kawasakizx10rr/HydroController/Code/ESP8266/ReadMe.MD

This code has not been fully tested, as such this code is not currently fit for release, please only use this code for testing.
