kawasakizx10rr/HydroController/PCB/Hydro Iss8 to Iss9 changes.docx

1. Added I2C header (PL12)

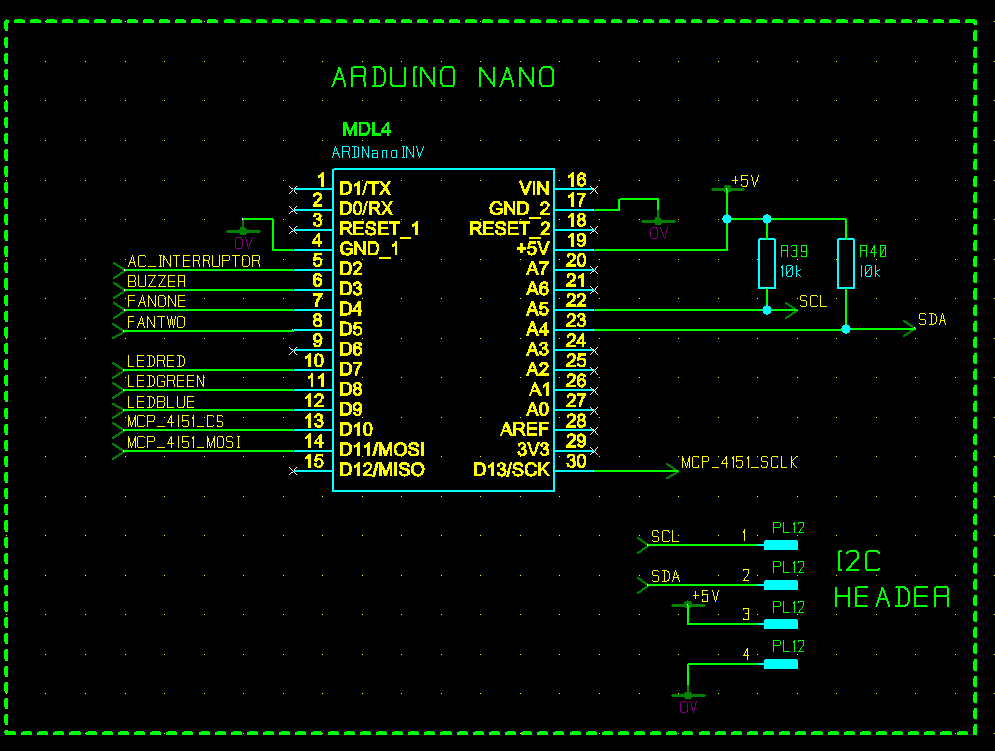
[picture p11: figure]
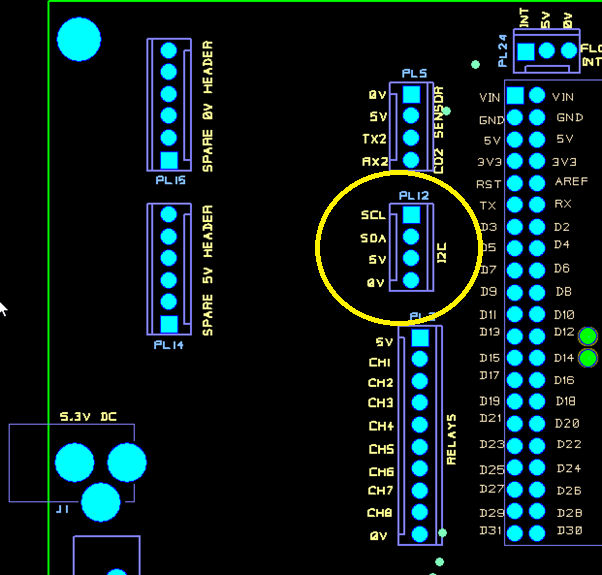
[picture p12: figure]

2. Add TFT jumper select 3V3 or 5V (PL28)

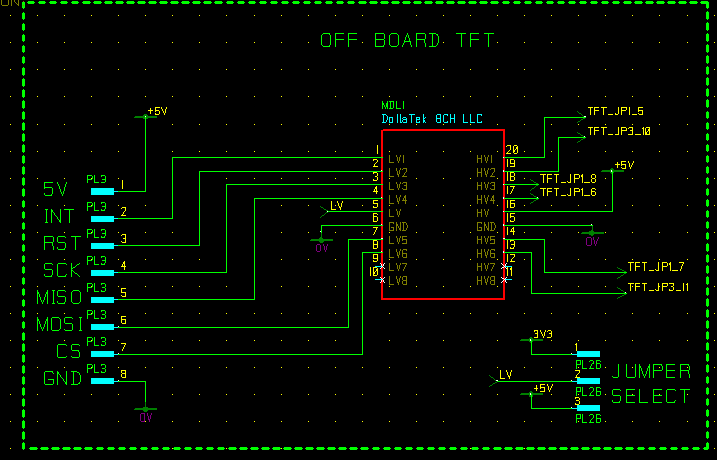
[picture p13: figure]
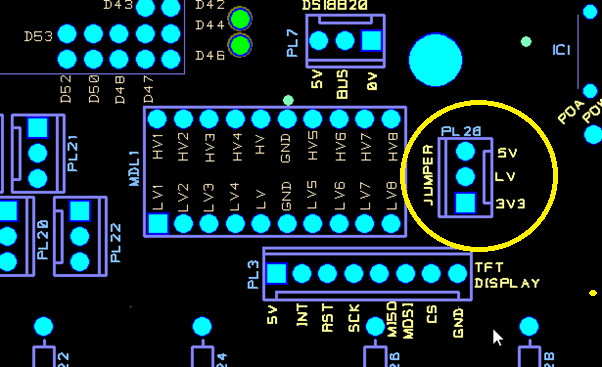
[picture p14: figure]

3. Add Analog potentiometer (R31) as an alternative to digital with DIP switches (S2).

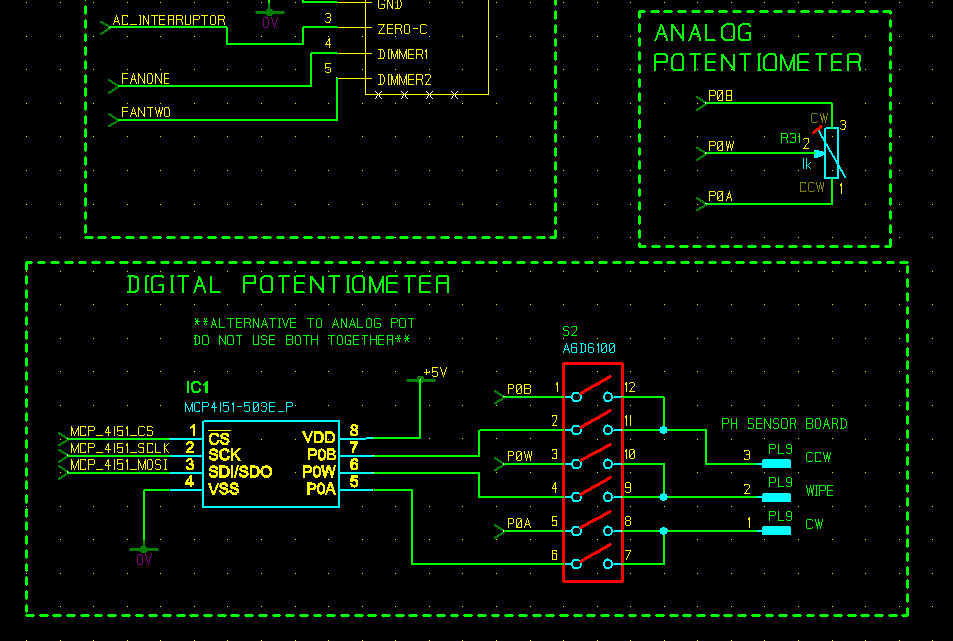
[picture p15: figure]
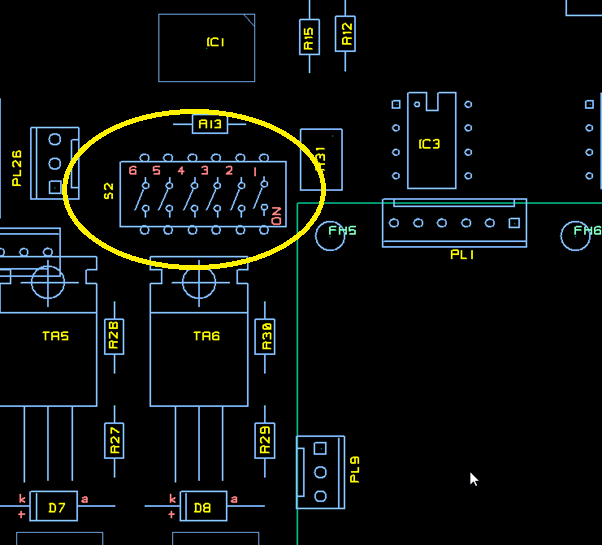
[picture p16: figure]

4. Add adjustable switching (Boost) regulator to power the pumps (MDL6).

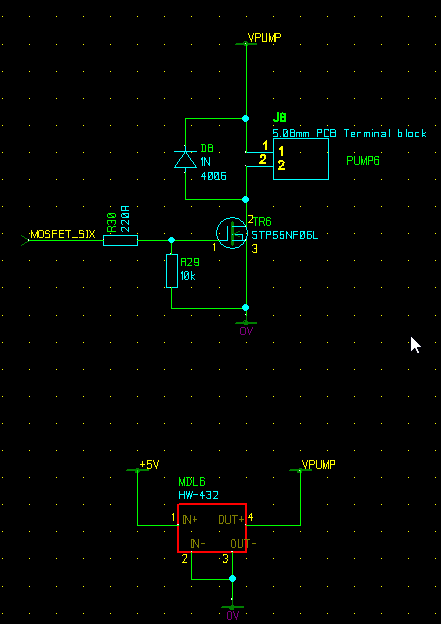
[picture p17: figure]
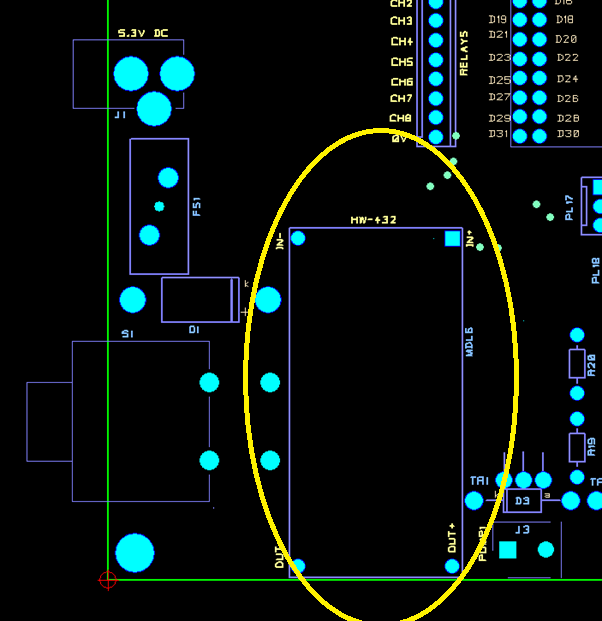
[picture p18: figure]

Overall board shown

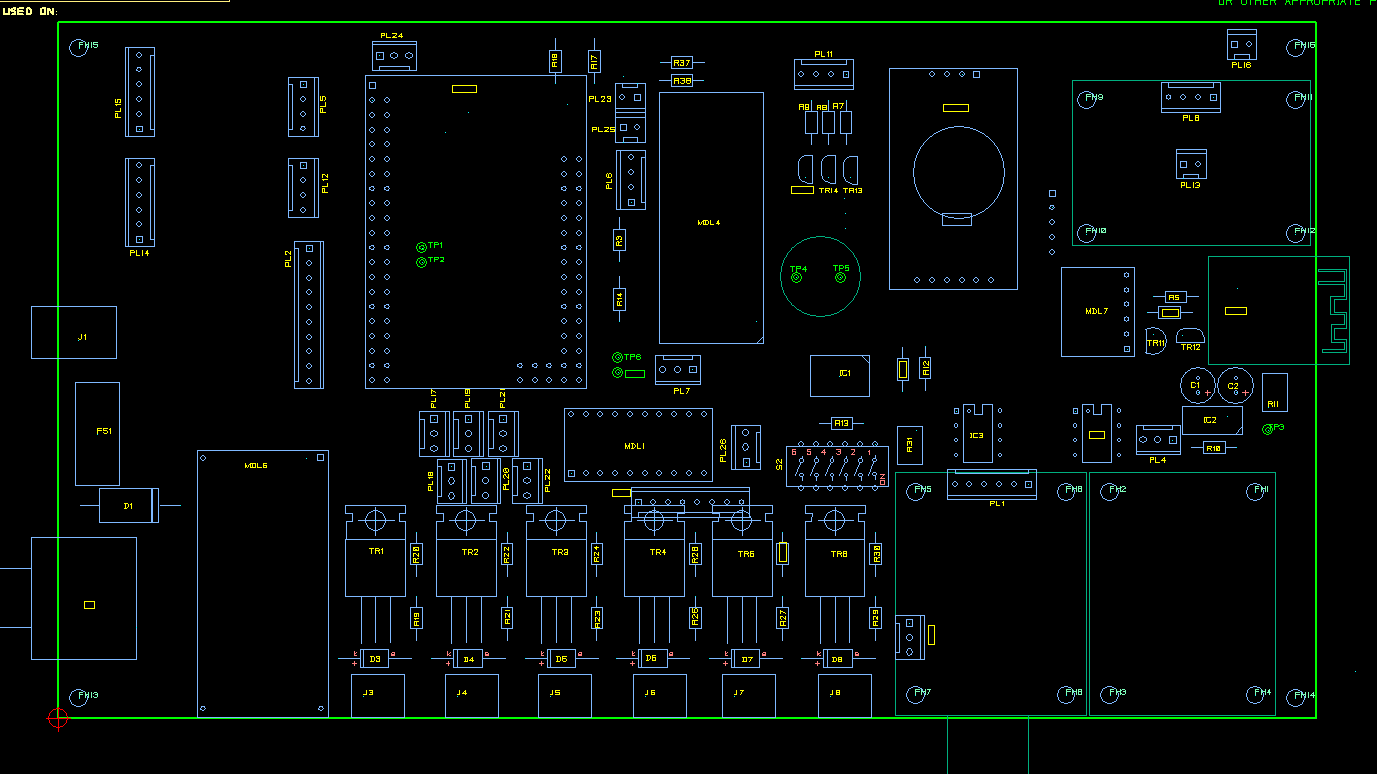
[picture p19: figure]

Top side

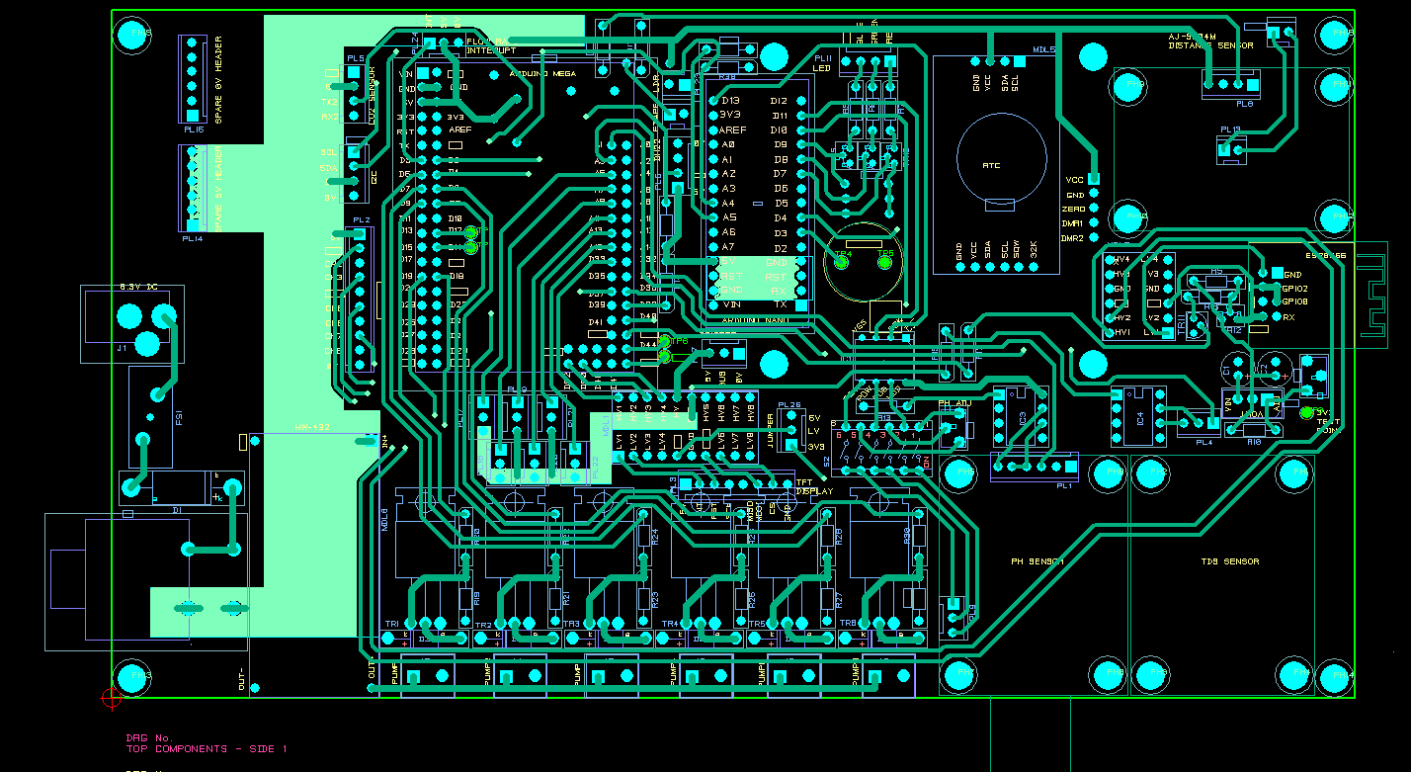
[picture p20: figure]

Bottom side (looking through board)

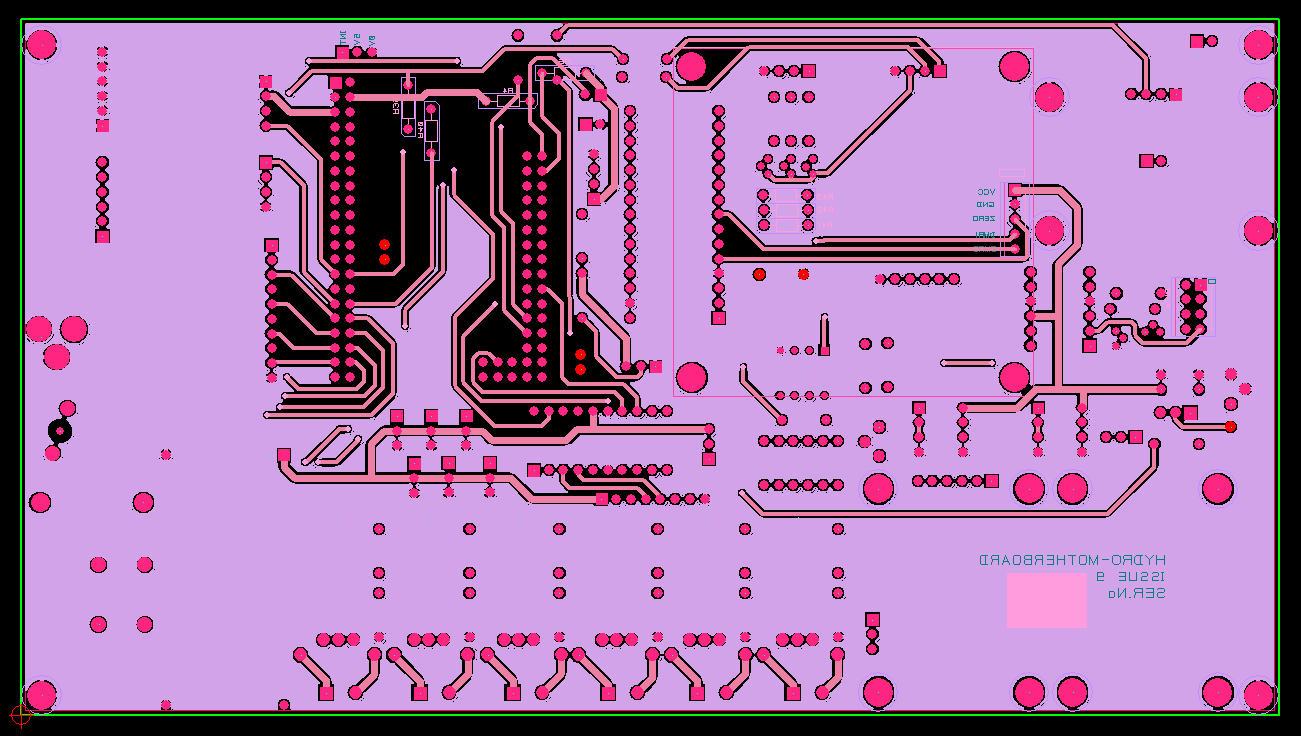
[picture p21: figure]
