kawasakizx10rr/HydroController/(threads)

Thread 3 (2023-12-04):

A few bugs

lvagabond, 2023-12-04:
Hi, your controller is great, but I ran into a few bugs while using it. In the controller log, wrong characters appear or they overlap and another error, when changing the number of dispensers to 4 and then back to 6, it is no longer possible to melt and there is even 16. What is the reason for this? Or is the fault only with my regulator?

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

lvagabond, 2023-12-05:
Hi Edwin, I'm glad for your project, it's a wonderful thing. Your last video on YT was a year ago. I thought the project was no longer alive. I tried to contact you by email, but no response. I would be interested in minor software modification and the addition of air heating. I will be happy to support you financially in this project, if it is an acceptable price. Please try to look in the email box and find the sender ***@***.******@***.***
Your work is seriously amazing.
 Thanks again.
Luke
On 5. 12. 2023 at 16:14 +0100, kawasakizx10rr/HydroController ***@***.***>, wrote:
> You are receiving this because you authored the thread

kawasakizx10rr, 2023-12-05:
4.5.3 is now available, are check my emails tonight to see if i still have it, as im one of those people that wipes my emails every month and i may have not read it, as i have a lot on these day but i am happy to add air heating or whatever, i recently made a AC controller but condensation is a issue if you don't an fresh air intake of at least 10% volume

lvagabond, 2023-12-05:
Cool job. I'm going to upload it. Thanks a lot

kawasakizx10rr, 2023-12-05:
I can not find your email so i must have deleted it, can you send it again, and a few minutes after i added my last message i had updated another file which was in debug mode so if you see the sensors are not working, download the code again.

lvagabond, 2023-12-05:
Good. I'll send the email again in a few minutes, I'll have it in my outbox. Thanks Edwin.

lvagabond, 2023-12-05:
Try checking Edwin's email.

Closed 2023-12-05.
