kawasakizx10rr/HydroController/PCB/Hydro-motherboard-GA-Btm-Iss9.pdf

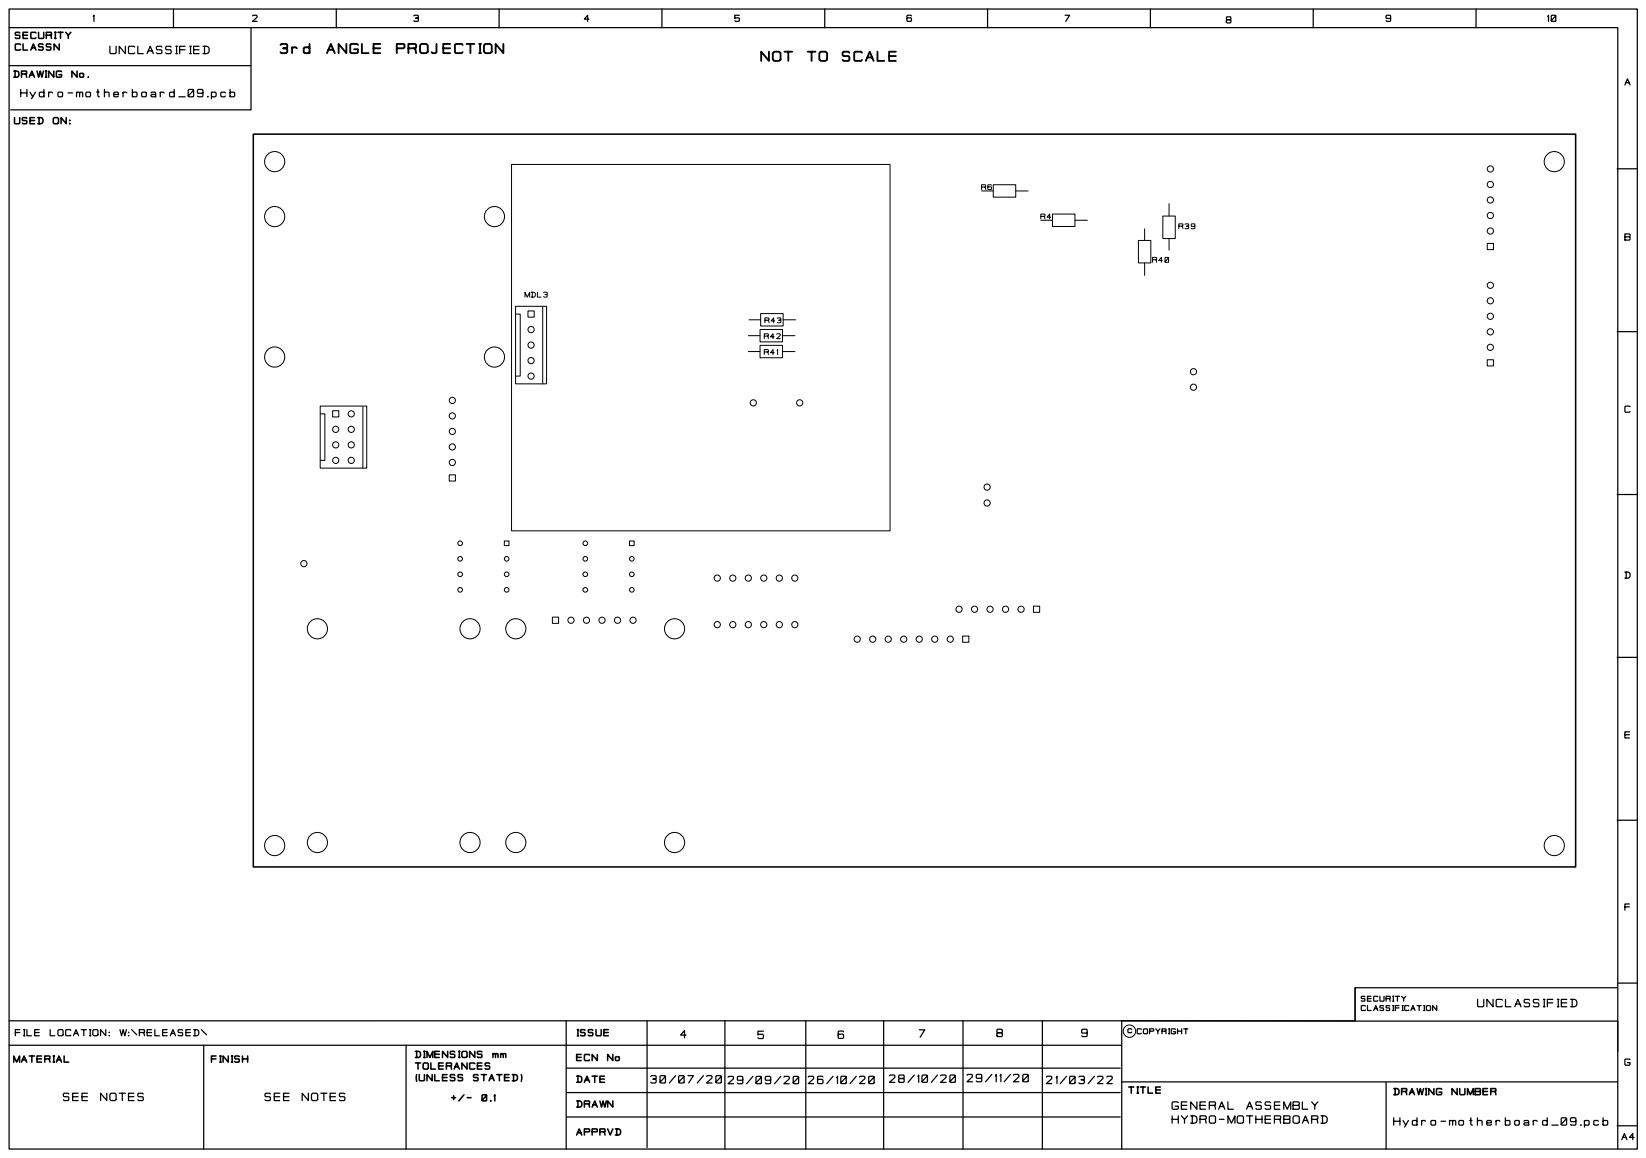
[picture p25: page 1]
