kawasakizx10rr/HydroController/PCB/Hydro-motherboard-GA-Top-Iss9.pdf

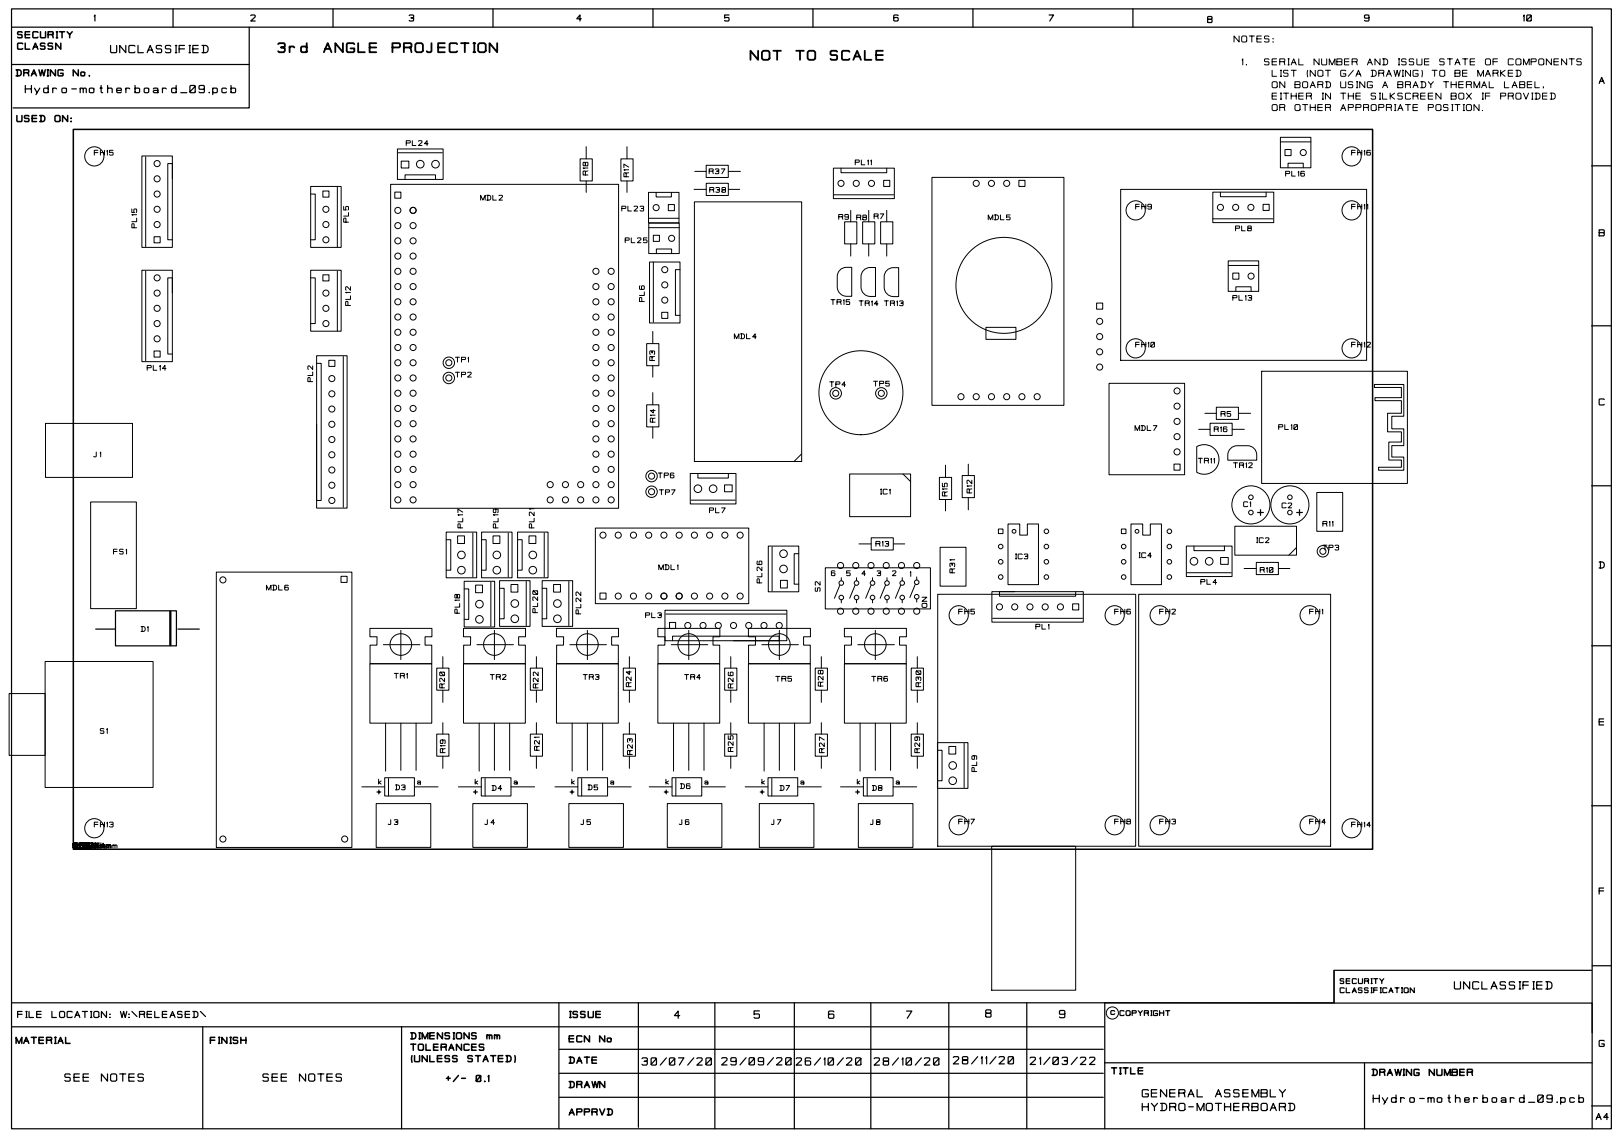
[picture p26: page 1]
