kawasakizx10rr/HydroController/Code/hydoController_4_9_4/Touch.ino

void touchEvent() {
   if (tft.touched()) {
    tft.touchReadPixel(&display::touch_x, &display::touch_y, 10);
    display::lastTouchMillis = millis();
    if (display::touch_x > 0 && display::touch_y > 0) {     
      //tft.fillCircle(display::touch_x, display::touch_y, 2, RA8875_WHITE); // for touch debugging
      sliders();
      static uint32_t previousTouchMillis = 0;
      if (millis() - previousTouchMillis >= display::debounceTime) {       
        if ((display::touch_x >= 0 && display::touch_x <= 80 && display::touch_y >= 0 && display::touch_y <= 480)
        || (display::touch_x >= 0 && display::touch_x <= 800 && display::touch_y >= 0 && display::touch_y <= 80)) {
          mainMenuNavigation();
        }
        else {
          adjustPageValues();
        }
        previousTouchMillis = millis();
      }      
    }
  }
  else if (millis() - display::lastTouchMillis >= 250UL) {
    display::touchStartMillis = millis();
    display::scrollLeftCount = 0;
    display::scrollRightCount = 0;
    display::lastScrollX = 0;//display::touch_x + 20;
    display::debounceTime = 200;
  }    
}

void mainMenuNavigation() {
  if (!display::displayIsOff) {
    if (display::touch_x >= 10 && display::touch_x <= 90 && display::touch_y >= 90 && display::touch_y <= 160) { // HOME
      setPage(0);
      device::slideShowpreviousMillis = millis();
    }
    else if (display::touch_x >= 10 && display::touch_x <= 90 && display::touch_y >= 160 && display::touch_y <= 230) { // GRAPH
      setPage(1);
    }
    else if (display::touch_x >= 10 && display::touch_x <= 90 && display::touch_y >= 230 && display::touch_y <= 300) { // MAX MINS
      display::maxMinsPage = 0;
      setPage(2);
    }
    else if (display::touch_x >= 10 && display::touch_x <= 90 && display::touch_y >= 300 && display::touch_y <= 370) { // PROFILES
      display::showKeyboard = false;
      device::lockSaveButtons = false;
      device::updateKeyboardInput = false;
      setPage(3);
    }
    else if (display::touch_x >= 10 && display::touch_x <= 90 && display::touch_y >= 370 && display::touch_y <= 450) { // SETTINGS
      display::co2PageScrollPos = 0;
      display::waterPageScrollPos = 0;
      display::doserPageScrollPos = 0;
      display::calDoserPageScrollPos = 0;
      display::calPhPageScrollPos = 0;
      display::calTdsPageScrollPos = 0;
      display::refillDoserPageScrollPos = 0;
      display::timerPagePageScrollPos = 0; ////////////////
      display::settingsPage = 0;
      display::settingsPageZeroScrollPos = 0;
      display::settingsPageOneScrollPos = 0;
      display::settingsPageTwoScrollPos = 0;
      display::settingsPageThreeScrollPos= 0;
      display::systemLogScrollPos = 0;
      display::setRtcTimePos = 0;
      display::maxMinsPage = 0;
      display::fansPage = 0;
      display:: warningsPage = 0;
      display::showCalErrorMessage = false;
      display::showingDialog = false;
      display::showInfoDialog = false;
      display::showSystemLogs = false;
      display::showAfkTime = false;
      display::showWifiSsid = false;
      display::showWifiPassword = false;
      display::showGraphInterval = false;
      display::showNumberOfDosers = false;
      display::showDosingInterval = false;
      display::showEcDosingMode = false;
      display::showPhDosingMode = false;
      display::showSr04HeightCalibration = false;
      display::showDoserCalibration = false;
      display::showTdsCalibration = false;
      display::showCo2Calibration = false;
      display::showPhCalibration = false;
      display::showRTCtime = false;
      display::showKeyboard = false;
      display::showSaveDialog = false;
      setPage(4);
    }
    else if (display::touch_x >= 15 && display::touch_x <= 95 && display::touch_y >= 1 && display::touch_y <= 100) { // EC / TDS
      setPage(5);
    }
    else if (display::touch_x >= 116 && display::touch_x <= 196 && display::touch_y >= 1 && display::touch_y <= 100) { // PH
      setPage(6);
    }
    else if (display::touch_x >= 223 && display::touch_x <= 303 && display::touch_y >= 1 && display::touch_y <= 100) { // CO2
      display::co2PageScrollPos = 0;
      setPage(7);
    }
    else if (display::touch_x >= 324 && display::touch_x <= 404 && display::touch_y >= 1 && display::touch_y <= 100) { // WATER height / LVL
      display::waterPageScrollPos = 0;
      setPage(8);
    }
    else if (display::touch_x >= 420 && display::touch_x <= 500 && display::touch_y >= 1 && display::touch_y <= 100) { // DOSERS
      setPage(9);
      display::doserPageScrollPos = 0;
    }
    else if (display::touch_x >= 507 && display::touch_x <= 587 && display::touch_y >= 1 && display::touch_y <= 100) { // LIGHT
      setPage(10);
    }
    else if (display::touch_x >= 596 && display::touch_x <= 676 && display::touch_y >= 1 && display::touch_y <= 100) { // FANS
      display::fansPage = 0;
      setPage(11);
    }
    if (display::touch_x >= 696 && display::touch_x <= 776 && display::touch_y >= 1 && display::touch_y <= 100) { // WARNINGS
      display::warningsPage = 0;
      setPage(12);
    }
  }
}

void sliders() {
  const int16_t slideXIncrement = sliderXTouch();
  const int16_t slideYIncrement = sliderYTouch();
  // Home page X axsis slider
  if (display::page == 0) {
    if (slideXIncrement != 0) {
      if (slideXIncrement == 1) {
        if (display::homePage < 9)
          display::homePage += slideXIncrement;
        else
          display::homePage = 0;
      }
      else if (slideXIncrement == -1) {
        if (display::homePage > 0)
          display::homePage += slideXIncrement;
        else
          display::homePage = 9;
      }
      beep();
      clearPage();
      refreshPage(true, 21);
      device::slideShowpreviousMillis = millis();
    }
  }
  // MaxMins page X axsis slider
  else if (display::page == 2) {
    if (slideXIncrement != 0) {
      if (slideXIncrement == 1) {
        if (display::maxMinsPage < 9)
          display::maxMinsPage++;
        else
          display::maxMinsPage = 0;
      }
      else if (slideXIncrement == -1) {
        if (display::maxMinsPage > 0)
          display::maxMinsPage--;
        else
          display::maxMinsPage = 9;
      }
      beep();
      refreshPage(true, 22);
      clearPage();
    }
  }
  // Settings page zero Y axsis slider
  else if (display::page == 4) {
    // Doser calibration settings page X axsis slider
    if (display::showDoserCalibration) {
      if (slideXIncrement == 1 && display::calDoserPageScrollPos < user::numberOfDosers - 4) {
        display::calDoserPageScrollPos++;
        refreshPage(true, 23);
        beep();
        clearPage();
      }
      else if (slideXIncrement == -1 && display::calDoserPageScrollPos > 0) {
        display::calDoserPageScrollPos--;
        refreshPage(true, 24);
        beep();
        clearPage();
      }
    }
    // PH calibration settings page
    else if (display::showPhCalibration) {
      if (slideXIncrement == 1 && display::calPhPageScrollPos < 2) {
        display::calPhPageScrollPos++;
        refreshPage(true, 25);
        beep();
        clearPage();
      }
      else if (slideXIncrement == -1 && display::calPhPageScrollPos > 0) {
        display::calPhPageScrollPos--;
        refreshPage(true, 26);
        beep();
        clearPage();
      }
    }
    //
    else if (display::showSystemLogs) {
      if (slideYIncrement == 1 && message::systemLogPos > 5 && display::systemLogScrollPos < message::systemLogPos - 6) {
        display::systemLogScrollPos++;       
        refreshPage(true, 27);
        beep();
        clearPage();
      }
      else if (slideYIncrement == -1 && display::systemLogScrollPos > 0) {
        display::systemLogScrollPos--;
        refreshPage(true, 28);
        beep();
        clearPage();
      }
      //Serial.print(F("systemLogScrollPos: ")); Serial.print(display::systemLogScrollPos); Serial.print(F(", max systemLogPos: ")); Serial.println(message::systemLogPos);
    }
    // Settings page X axsis slider
    else if (!display::showingDialog) {
      if (slideXIncrement == 1 && display::settingsPage < 4) {
        display::settingsPage++;
        refreshPage(true, 29);
        beep();
        clearPage();
      }
      else if (slideXIncrement == -1 && display::settingsPage > 0) {
        display::settingsPage--;
        refreshPage(true, 30);
        beep();
        clearPage();
      }
    }
  }
  // Co2 page X axsis slider
  else if (display::page == 7) {
    if (slideXIncrement == 1 && display::co2PageScrollPos < 3) {
      display::co2PageScrollPos++;
      refreshPage(true, 31);
      beep();
      clearPage();
    }
    else if (slideXIncrement == -1 && display::co2PageScrollPos > 0) {
      display::co2PageScrollPos--;
      refreshPage(true, 32);
      beep();
      clearPage();
    }
  }
  // Water page X axsis slider
  else if (display::page == 8) {
    if (slideXIncrement == 1) {
      if (display::waterPageScrollPos < 4) {
        display::waterPageScrollPos++;
        refreshPage(true, 33);
        beep();
        clearPage();
      }
      else if (display::waterPageScrollPos == 4 && display::refillDoserPageScrollPos < user::numberOfDosers - 4) {
        display::refillDoserPageScrollPos++;
        refreshPage(true, 34);
        beep();
        clearPage();
      }
    }
    else if (slideXIncrement == -1) {
      if (display::waterPageScrollPos == 4 && display::refillDoserPageScrollPos > 0) {
        display::refillDoserPageScrollPos--;
        refreshPage(true, 35);
        beep();
        clearPage();
      }
      else if (display::waterPageScrollPos > 0) {
        display::waterPageScrollPos--;
        refreshPage(true, 36);
        beep();
        clearPage();
      }
    }
  }
  // Dosers page X axsis slider
  else if (display::page == 9) {
    if (slideXIncrement == 1 && display::doserPageScrollPos < user::numberOfDosers - 4) {
      display::doserPageScrollPos++;
      refreshPage(true, 37);
      beep();
      clearPage();
    }
    else if (slideXIncrement == -1 && display::doserPageScrollPos > 0) {
      display::doserPageScrollPos--;
      refreshPage(true, 38);
      beep();
      clearPage();
    }
  }
  // Timers page X axsis slider
  else if (display::page == 10) {
    if (slideXIncrement == 1 && display::timerPagePageScrollPos < 3) {
      display::timerPagePageScrollPos++;
      refreshPage(true, 39);
      beep();
      clearPage();
    }
    else if (slideXIncrement == -1 && display::timerPagePageScrollPos > 0) {
      display::timerPagePageScrollPos--;
      refreshPage(true, 40);
      beep();
      clearPage();
    }
  }
  // Fans page X axsis slider
  else if (display::page == 11) {
    if (slideXIncrement == 1 && display::fansPage < 6) {
      display::fansPage++;
      refreshPage(true, 41);
      beep();
      clearPage();
    }
    else if (slideXIncrement == -1 && display::fansPage > 0) {
      display::fansPage--;
      refreshPage(true, 42);
      beep();
      clearPage();
    }
  }
  // Warnings page X axsis slider
  else if (display::page == 12) {
    if (slideXIncrement != 0) {
      if (slideXIncrement == 1) {
        if (display::warningsPage < 7)
          display::warningsPage++;
        else
          display::warningsPage = 0;
      }
      else if (slideXIncrement == -1) {
        if (display::warningsPage > 0)
          display::warningsPage--;
        else
          display::warningsPage = 7;
      }
      beep();
      refreshPage(true, 43);
      clearPage();
    }
  }
}

int16_t sliderXTouch() {
  int16_t returnVal = 0;
  if ((int16_t)display::touch_x > (display::lastScrollX + 20)) {
    //if ((int16_t)display::touch_x - (int16_t)display::lastTouchX >= 35) {
      display::scrollRightCount++;
      //Serial.print(F("touch_x ")); Serial.println(display::touch_x);
      //Serial.print(F("slide R ")); Serial.println(display::scrollRightCount);
      if (display::scrollRightCount >= 1)
        display::scrollLeftCount = 0;
      display::lastScrollX = display::touch_x;
    //}
  }
  else if ((int16_t)display::touch_x < (display::lastScrollX - 20)) {
    //else if ((int16_t)display::touch_x - (int16_t)display::lastTouchX <= -35) {    
      display::scrollLeftCount++;
      //Serial.print(F("touch_x ")); Serial.println(display::touch_x);
      //Serial.print(F("slide L ")); Serial.println(display::scrollLeftCount);
      if (display::scrollLeftCount >= 1)
        display::scrollRightCount = 0;
      display::lastScrollX = display::touch_x;
   // }
  }
  if (display::scrollRightCount >= 6) {
    returnVal = 1;
    //display::lastTouchX = 0;
  }
  else if (display::scrollLeftCount >= 6) {
    returnVal = -1;
    //display::lastTouchX = tft.width();
  }
  if (returnVal != 0) {
    display::scrollLeftCount = 0;
    display::scrollRightCount = 0;
    //Serial.print(F("slide x touch ")); Serial.println(returnVal);
  }
  return returnVal;
}

int16_t sliderYTouch() {
  static int16_t scrollDownCount = 0, scrollUpCount = 0;
  int16_t returnVal = 0;
  //if (display::currentTouch > display::lastTouch) {
    if ((int16_t)display::touch_y - (int16_t)display::lastTouchY >= 20) {
      scrollDownCount++;
      scrollUpCount = 0;
      display::lastTouchY = display::touch_y;
    }
    else if ((int16_t)display::touch_y - (int16_t)display::lastTouchY <= -20) {
      scrollUpCount++;
      scrollDownCount = 0;
      display::lastTouchY = display::touch_y;
    }
  //}
  if (scrollDownCount >= 10) {
    returnVal = 1;
    scrollDownCount = 0;
    //display::lastDownTouch = 0;
  }
  else if (scrollUpCount >= 10) {
    returnVal = -1;
    scrollUpCount = 0;
    //display::lastUpTouch = tft.height();
  }
  //if (returnVal != 0) {
  //Serial.print(F("slide y touch ")); Serial.println(returnVal);
  //}
  return returnVal;
}

void adjustPageValues() {
  if (display::showInfoDialog)
    infoDialogTouched();
  else if (display::page == 1)
    graphsPageTouched();
  else if (display::page == 2)
    maxMinsPageTouched();
  else if (display::page == 3)
    profilesPageTouched();
  else if (display::page == 4)
    settingsPageTouched();
  else if (display::page == 5)
    ecTdsPageTouched();
  else if (display::page == 6)
    phPageTouched();
  else if (display::page == 7)
    co2PageTouched();
  else if (display::page == 8)
    waterPageTouched();
  else if (display::page == 9)
    dosersPageTouched();
  else if (display::page == 10)
    timerPagedTouched();
  else if (display::page == 11)
    fansPageTouched();
  else if (display::page == 12)
    warningsPageTouched();
}

void infoDialogTouched() {
  if (millis() - display::infoDialogDisplayTime > 3000UL) {
    if (display::touch_x >= 100 && display::touch_x <= 800 && display::touch_y >= 100 && display::touch_y <= 480) {
      Serial.println(F("Closing infoDialog..."));
      clearPage();
      display::showingDialog = false;
      display::showInfoDialog = false;
      refreshPage(true, 44);
    }
  }
}

void graphsPageTouched() {
  static uint32_t graphTouchPreviousMillis = 0;
  if (millis() - graphTouchPreviousMillis >= 500UL) {
    if (display::touch_x >= 760 && display::touch_x <= 835) {
      if (display::touch_y >= 90 && display::touch_y <= 124)
        display::showTdsGraph = !display::showTdsGraph;
      else if ( display::touch_y >= 124 && display::touch_y <= 158)
        display::showPhGraph = !display::showPhGraph;
      else if ( display::touch_y >= 158 && display::touch_y <= 192)
        display::showEcGraph = !display::showEcGraph;
      else if ( display::touch_y >= 192 && display::touch_y <= 230)
        display::showCo2Graph = !display::showCo2Graph;
      else if ( display::touch_y >= 230 && display::touch_y <= 268)
        display::showWaterTempGraph = !display::showWaterTempGraph;
      else if ( display::touch_y >= 268 && display::touch_y <= 310)
        display::showWaterLvlGraph = !display::showWaterLvlGraph;
      else if ( display::touch_y >= 310 && display::touch_y <= 354)
        display::showFanOneGraph = !display::showFanOneGraph;
      else if ( display::touch_y >= 354 && display::touch_y <= 394)
        display::showFanTwoGraph = !display::showFanTwoGraph;
      else if ( display::touch_y >= 394 && display::touch_y <= 434)
        display::showAirTempGraph = !display::showAirTempGraph;
      else if ( display::touch_y >= 434 && display::touch_y <= 474)
        display::showHumidityGraph = !display::showHumidityGraph;
      beep();
      refreshPage(true, 45);
    }
    graphTouchPreviousMillis = millis();
  }
}

void maxMinsPageTouched() {
  if (display::touch_x >= 770 && display::touch_x <= 800 && display::touch_y >= 120 && display::touch_y <= 140) { // show info dialog
    message::infoPos = 20;
    display::showingDialog = true;
    display::showInfoDialog = true;
    refreshPage(true, 46);
    display::infoDialogDisplayTime = millis();
  }
}

void profilesPageTouched() {
  if (display::showSaveDialog && !display::showKeyboard) {
    if (display::touch_x >= 284 && display::touch_x <= 422 && display::touch_y >= 368 && display::touch_y <= 414) { // cancel saving profile
      beep();
      display::showSaveDialog = false;
      refreshPage(true, 47);
      clearPage();
    }
    else if (display::touch_x >= 460 && display::touch_x <= 638 && display::touch_y >= 368 && display::touch_y <= 414) { // continue with saving profile
      beep();
      getSetSystemEEPROM(device::EEPROM_SET);
      device::settingsAdjusted = true;
      delay(20);
      EEPROM.put(6, device::userProfile);
      delay(20);
      device::lockSaveButtons = true;
      device::keyBoardClosedTime = millis();
      getSetProfileEEPROM(device::userProfile, device::EEPROM_SET);
      display::showSaveDialog = false;
      refreshPage(true, 48);
      clearPage();
    }
    else if (display::touch_x >= 770 && display::touch_x <= 800 && display::touch_y >= 120 && display::touch_y <= 140) { // show info dialog
      message::infoPos = 21;
      display::showingDialog = true;
      display::showInfoDialog = true;
      refreshPage(true, 49);
      display::infoDialogDisplayTime = millis();
    }
  }
  else if (device::lockSaveButtons) {
    if (millis() - device::keyBoardClosedTime >= 3000UL) {
      device::lockSaveButtons = false;
      Serial.println(F("Unlocking save/load buttons"));
    }
  }
  else if (!display::showKeyboard && !device::lockSaveButtons) {
    // Keybaord save, load, input box buttons
    if (display::touch_x >= 130 && display::touch_x <= 470 && display::touch_y >= 160 && display::touch_y <= 202)
      loadKeyBoard(1);
    else if (display::touch_x >= 130 && display::touch_x <= 470 && display::touch_y >= 222 && display::touch_y <= 262)
      loadKeyBoard(2);
    else if (display::touch_x >= 130 && display::touch_x <= 470 && display::touch_y >= 284 && display::touch_y <= 326)
      loadKeyBoard(3);
    else if (display::touch_x >= 130 && display::touch_x <= 470 && display::touch_y >= 346 && display::touch_y <= 388)
      loadKeyBoard(4);
    else if (display::touch_x >= 130 && display::touch_x <= 470 && display::touch_y >= 408 && display::touch_y <= 450)
      loadKeyBoard(5);
    else if (display::touch_x >= 490 && display::touch_x <= 620 && display::touch_y >= 160 && display::touch_y <= 202) {
      beep();
      device::userProfile = 0;
      refreshPage(true, 50);
      display::showSaveDialog = true;
    }
    else if (display::touch_x >= 490 && display::touch_x <= 620 && display::touch_y >= 222 && display::touch_y <= 262) {
      beep();
      device::userProfile = 1;
      device::settingsAdjusted = true;
      refreshPage(true, 51);
      display::showSaveDialog = true;
    }
    else if (display::touch_x >= 490 && display::touch_x <= 620 && display::touch_y >= 284 && display::touch_y <= 326) {
      beep();
      device::userProfile = 2;
      device::settingsAdjusted = true;
      refreshPage(true, 52);
      display::showSaveDialog = true;;
    }
    else if (display::touch_x >= 490 && display::touch_x <= 620 && display::touch_y >= 346 && display::touch_y <= 388) {
      beep();
      device::userProfile = 3;
      device::settingsAdjusted = true;
      refreshPage(true, 53);
      display::showSaveDialog = true;
    }
    else if (display::touch_x >= 490 && display::touch_x <= 620 && display::touch_y >= 408 && display::touch_y <= 450) {
      beep();
      device::userProfile = 4;
      device::settingsAdjusted = true;
      refreshPage(true, 54);
      display::showSaveDialog = true;
    }
    else if (display::touch_x >= 630 && display::touch_x <= 760 && display::touch_y >= 160 && display::touch_y <= 202) {
      beep();
      device::userProfile = 0;
      device::settingsAdjusted = true;
      refreshPage(true, 55);
      device::lockSaveButtons = true;
      device::keyBoardClosedTime = millis();
      getSetProfileEEPROM(device::userProfile, device::EEPROM_GET);
      EEPROM.put(6, device::userProfile);
      delay(20);
    }
    else if (display::touch_x >= 630 && display::touch_x <= 760 && display::touch_y >= 222 && display::touch_y <= 262) {
      beep();
      device::userProfile = 1;
      device::settingsAdjusted = true;
      refreshPage(true, 56);
      device::lockSaveButtons = true;
      device::keyBoardClosedTime = millis();
      getSetProfileEEPROM(device::userProfile, device::EEPROM_GET);
      EEPROM.put(6, device::userProfile);
      delay(20);
    }
    else if (display::touch_x >= 630 && display::touch_x <= 760 && display::touch_y >= 284 && display::touch_y <= 326) {
      beep();
      device::userProfile = 2;
      device::settingsAdjusted = true;
      refreshPage(true, 57);
      device::lockSaveButtons = true;
      device::keyBoardClosedTime = millis();
      getSetProfileEEPROM(device::userProfile, device::EEPROM_GET);
      EEPROM.put(6, device::userProfile);
      delay(20);
    }
    else if (display::touch_x >= 630 && display::touch_x <= 760 && display::touch_y >= 346 && display::touch_y <= 388) {
      beep();
      device::userProfile = 3;
      device::settingsAdjusted = true;
      refreshPage(true, 58);
      device::lockSaveButtons = true;
      device::keyBoardClosedTime = millis();
      getSetProfileEEPROM(device::userProfile, device::EEPROM_GET);
      EEPROM.put(6, device::userProfile);
      delay(20);
    }
    else if (display::touch_x >= 630 && display::touch_x <= 760 && display::touch_y >= 408 && display::touch_y <= 450) {
      beep();
      device::userProfile = 4;
      device::settingsAdjusted = true;
      refreshPage(true, 59);
      device::lockSaveButtons = true;
      device::keyBoardClosedTime = millis();
      getSetProfileEEPROM(device::userProfile, device::EEPROM_GET);
      EEPROM.put(6, device::userProfile);
      delay(20);
    }
  }
  else if (display::showKeyboard) {
    char* a_charPtr = NULL;
    if (device::profileInputNumber == 1)
      a_charPtr = user::profileOneName;
    else if (device::profileInputNumber == 2)
      a_charPtr = user::profileTwoName;
    else if (device::profileInputNumber == 3)
      a_charPtr = user::profileThreeName;
    else if (device::profileInputNumber == 4)
      a_charPtr = user::profileFourName;
    else if (device::profileInputNumber == 5)
      a_charPtr = user::profileFiveName;
    static uint32_t previousKeyTouch;
    if (millis() - previousKeyTouch > 500UL) {
      keyboardTouched(a_charPtr, 16);
      previousKeyTouch = millis();
    }
  }
}

void settingsPageTouched() {
  // DISPLAY SETTINGS
  if (display::settingsPage == 0)
    settingsZeroPageTouched();
  else if (display::settingsPage == 1)
    settingsOnePageTouched();
  else if (display::settingsPage == 2)
    settingsTwoPageTouched();
  else if (display::settingsPage == 3)
    settingsThreePageTouched();
  else if (display::settingsPage == 4)
    settingsFourPageTouched();
}


void settingsZeroPageTouched() {
  if (display::showRTCtime) {
    if (display::touch_x >= 295 && display::touch_x <= 345 && display::touch_y >= 375 && display::touch_y <= 425 ) { // setRtcTimePos right
      display::setRtcTimePos = adjustValue(display::setRtcTimePos, 1, 0, 7);
      refreshPage(true, 60);
    }
    else if (display::touch_x >= 385 && display::touch_x <= 435 && display::touch_y >= 375 && display::touch_y <= 425 ) { // setRtcTimePos left
      display::setRtcTimePos = adjustValue(display::setRtcTimePos, -1, 0, 7);
      refreshPage(true, 61);
    }
    if (display::setRtcTimePos == 7)
      display::setRtcTimePos = 0;

    if (display::setRtcTimePos == 0) {
      if (display::touch_x >= 495 && display::touch_x <= 545 && display::touch_y >= 375 && display::touch_y <= 425 ) // rtcDay down
        user::rtcDayOfWeek = adjustValue(user::rtcDayOfWeek, -1, 0, 6);
      else if (display::touch_x >= 585 && display::touch_x <= 635 && display::touch_y >= 375 && display::touch_y <= 425 ) // rtcDay up
        user::rtcDayOfWeek = adjustValue(user::rtcDayOfWeek, 1, 0, 7);
      if (user::rtcDayOfWeek == 7)
        user::rtcDayOfWeek = 0;
    }
    else if (display::setRtcTimePos == 1) {
      if (display::touch_x >= 495 && display::touch_x <= 545 && display::touch_y >= 375 && display::touch_y <= 425 ) // rtcDay down
        user::rtcDay = adjustValue(user::rtcDay, -1, 1, 31);
      else if (display::touch_x >= 585 && display::touch_x <= 635 && display::touch_y >= 375 && display::touch_y <= 425 ) // rtcDay up
        user::rtcDay = adjustValue(user::rtcDay, 1, 1, 31);      
    }
    else if (display::setRtcTimePos == 2) {
      if (display::touch_x >= 495 && display::touch_x <= 545 && display::touch_y >= 375 && display::touch_y <= 425 ) // rtcMonth down
        user::rtcMonth = adjustValue(user::rtcMonth, -1, 1, 12);
      else if (display::touch_x >= 585 && display::touch_x <= 635 && display::touch_y >= 375 && display::touch_y <= 425 ) // rtcMonth up
        user::rtcMonth = adjustValue(user::rtcMonth, 1, 1, 12);      
    }
    else if (display::setRtcTimePos == 3) {
      if (display::touch_x >= 495 && display::touch_x <= 545 && display::touch_y >= 375 && display::touch_y <= 425 ) // rtcYear down
        user::rtcYear = adjustValue(user::rtcYear, -1, 24, 99);
      else if (display::touch_x >= 585 && display::touch_x <= 635 && display::touch_y >= 375 && display::touch_y <= 425 ) // rtcYear up
        user::rtcYear = adjustValue(user::rtcYear, 1, 24, 99);      
    }
    else if (display::setRtcTimePos == 4) {
      if (display::touch_x >= 495 && display::touch_x <= 545 && display::touch_y >= 375 && display::touch_y <= 425 ) // rtcHour down
        user::rtcHour = adjustValue(user::rtcHour, -1, 0, 23);
      else if (display::touch_x >= 585 && display::touch_x <= 635 && display::touch_y >= 375 && display::touch_y <= 425 ) // rtcHour up
        user::rtcHour = adjustValue(user::rtcHour, 1, 0, 23);      
    }
    else if (display::setRtcTimePos == 5) {
      if (display::touch_x >= 495 && display::touch_x <= 545 && display::touch_y >= 375 && display::touch_y <= 425 ) // rtcMinute down
        user::rtcMinute = adjustValue(user::rtcMinute, -1, 0, 59);
      else if (display::touch_x >= 585 && display::touch_x <= 635 && display::touch_y >= 375 && display::touch_y <= 425 ) // rtcMinute up
        user::rtcMinute = adjustValue(user::rtcMinute, 1, 0, 59);      
    }
    else {
      if (display::touch_x >= 495 && display::touch_x <= 545 && display::touch_y >= 375 && display::touch_y <= 425 ) // rtcSecond down
        user::rtcSecond = adjustValue(user::rtcSecond, -1, 0, 59);
      else if (display::touch_x >= 585 && display::touch_x <= 635 && display::touch_y >= 375 && display::touch_y <= 425 ) // rtcSecond up
        user::rtcSecond = adjustValue(user::rtcSecond, 1, 0, 59);      
    }
    if (display::touch_x >= 260 && display::touch_x <= 420 && display::touch_y >= 430 && display::touch_y <= 470) { // cancel
      beep();
      display::showRTCtime = false;
      clearPage();
      display::showingDialog = false;
      refreshPage(true, 62);
    }
    else if (display::touch_x >= 460 && display::touch_x <= 620 && display::touch_y >= 430 && display::touch_y <= 470) { // confirm
      beep();
      adjustrtc();
      display::showRTCtime = false;
      clearPage();
      display::showingDialog = false;
      refreshPage(true, 63);
    }
    else if (display::touch_x >= 770 && display::touch_x <= 800 && display::touch_y >= 120 && display::touch_y <= 140) { // show info dialog
      message::infoPos = 23;
      display::showingDialog = true;
      display::showInfoDialog = true;
      refreshPage(true, 64);
      display::infoDialogDisplayTime = millis();
    }
  }
  else if (display::showAfkTime) {
    if (display::touch_x >= 370 && display::touch_x <= 420 && display::touch_y >= 350 && display::touch_y <= 400) // afkTime time down
      user::afkTime = adjustValue(user::afkTime, -1, 0, 240);
    else if (display::touch_x >= 500 && display::touch_x <= 550 && display::touch_y >= 350 && display::touch_y <= 400) // afkTime time up
      user::afkTime = adjustValue(user::afkTime, 1, 0, 240);
    else if (display::touch_x >= 390 && display::touch_x <= 490 && display::touch_y >= 430 && display::touch_y <= 479) {// exit
      beep();
      clearPage();
      display::showAfkTime = false;
      refreshPage(true, 65);    
      display::showingDialog = false;
    }
    else if (display::touch_x >= 770 && display::touch_x <= 800 && display::touch_y >= 120 && display::touch_y <= 140) { // show info dialog
      message::infoPos = 24;
      display::showingDialog = true;
      display::showInfoDialog = true;
      refreshPage(true, 66);
      display::infoDialogDisplayTime = millis();
    }
  }
  else if (display::showBrightness) {
    if (display::touch_x >= 370 && display::touch_x <= 420 && display::touch_y >= 350 && display::touch_y <= 400) { // brightness down
      user::brightness = adjustValue(user::brightness, -1, 20, 100);
      tft.brightness(user::brightness);
    }
    else if (display::touch_x >= 500 && display::touch_x <= 550 && display::touch_y >= 350 && display::touch_y <= 400) { // brightness up
      user::brightness = adjustValue(user::brightness, 1, 20, 100);
      tft.brightness(user::brightness);
    }
    else if (display::touch_x >= 390 && display::touch_x <= 490 && display::touch_y >= 430 && display::touch_y <= 479) {// exit
      beep();
      clearPage();
      display::showBrightness = false;
      refreshPage(true, 67);    
      display::showingDialog = false;
    }
    else if (display::touch_x >= 770 && display::touch_x <= 800 && display::touch_y >= 120 && display::touch_y <= 140) { // show info dialog
      message::infoPos = 38;
      display::showingDialog = true;
      display::showInfoDialog = true;
      refreshPage(true, 68);
      display::infoDialogDisplayTime = millis();
    }
  }
  else if (display::showGraphInterval) {
    if (display::touch_x >= 370 && display::touch_x <= 420 && display::touch_y >= 350 && display::touch_y <= 400) // graphInterval time down
      user::graphInterval = adjustInterval(user::graphInterval, -1);
    else if (display::touch_x >= 500 && display::touch_x <= 550 && display::touch_y >= 350 && display::touch_y <= 400) // graphInterval time up
      user::graphInterval = adjustInterval(user::graphInterval, 1);
    else if (display::touch_x >= 390 && display::touch_x <= 490 && display::touch_y >= 430 && display::touch_y <= 479) {// exit
      beep();
      clearPage();
      display::showGraphInterval = false;
      refreshPage(true, 69);    
      display::showingDialog = false;
    }
    else if (display::touch_x >= 770 && display::touch_x <= 800 && display::touch_y >= 120 && display::touch_y <= 140) { // show info dialog
      message::infoPos = 25;
      display::showingDialog = true;
      display::showInfoDialog = true;
      refreshPage(true, 70);
      display::infoDialogDisplayTime = millis();
    }
  }
  else {
    int16_t scrollMargin = display::settingsPageZeroScrollPos * 50;
    // vertical menu slider
    static uint32_t lastTouchTime = 0;
    if (millis() - lastTouchTime >= 1500UL) {
      if (display::touch_x >= 760 && display::touch_x <= 800 && display::touch_y >= 100 && display::touch_y <= 140) {
        if (display::settingsPageZeroScrollPos > 0) {
          display::settingsPageZeroScrollPos--;
          refreshPage(true, 71);
          beep();
          clearPage();
        }
      } 
      else if (display::touch_x >= 760 && display::touch_x <= 800 && display::touch_y > 140 && display::touch_y < 430) {
        display::settingsPageZeroScrollPos = map(display::touch_y, 140, 430, 0, 4);
        if (display::settingsPageZeroScrollPos > 3)
          display::settingsPageZeroScrollPos = 3;
        //Serial.print(F("settingsPageZero slider menu pos = ")); Serial.println(display::settingsPageZeroScrollPos);
        refreshPage(true, 72);
        beep();
        clearPage();
      } 
      else if (display::touch_x >= 760 && display::touch_x <= 800 && display::touch_y >= 430 && display::touch_y <= 470) {
        if (display::settingsPageZeroScrollPos < 3) {
          display::settingsPageZeroScrollPos++;
          refreshPage(true, 73);
          beep();
          clearPage();
        }
      }
      lastTouchTime = millis();
    }
    //
    if (display::settingsPageZeroScrollPos == 0) {
      if (display::touch_x >= 508 && display::touch_x <= 538 && display::touch_y >= 168 - scrollMargin && display::touch_y <= 198 - scrollMargin) // Change background color to light blue
        setBackground(display::RA8875_LIGHT_BLUE);
      else if (display::touch_x >= 558 && display::touch_x <= 588 && display::touch_y >= 168 - scrollMargin && display::touch_y <= 198 - scrollMargin) // Change background color to light green
        setBackground(display::RA8875_LIGHT_GREEN);
      else if (display::touch_x >= 608 && display::touch_x <= 638 && display::touch_y >= 168 - scrollMargin && display::touch_y <= 198 - scrollMargin) // Change background color to light purple
        setBackground(RA8875_MAGENTA);
      else if (display::touch_x >= 658 && display::touch_x <= 688 && display::touch_y >= 168 - scrollMargin && display::touch_y <= 198 - scrollMargin) // Change background color to light pink
        setBackground(display::RA8875_LIGHT_PINK);
      else if (display::touch_x >= 708 && display::touch_x <= 738 && display::touch_y >= 168 - scrollMargin && display::touch_y <= 198 - scrollMargin) // Change background color to white
        setBackground(RA8875_WHITE);
    }
    if (display::settingsPageZeroScrollPos <= 1) {
      if (display::touch_x >= 680 && display::touch_x <= 750 && display::touch_y >= 220 - scrollMargin && display::touch_y <= 250 - scrollMargin) { // AfkTime
        beep();
        display::showAfkTime = true;
        display::showingDialog = true;
        clearPage();
        refreshPage(true, 74);
      }
    }
    if (display::settingsPageZeroScrollPos <= 2) {
      if (display::touch_x >= 680 && display::touch_x <= 750 && display::touch_y >= 270 - scrollMargin && display::touch_y <= 300 - scrollMargin) { // display brightness
        beep();
        display::showBrightness = true;
        display::showingDialog = true;
        clearPage();
        refreshPage(true, 75);
      }
    }
    if (display::settingsPageZeroScrollPos <= 3) {
      if (display::touch_x >= 680 && display::touch_x <= 750 && display::touch_y >= 320 - scrollMargin && display::touch_y <= 350 - scrollMargin) { // graphInterval
        beep();
        display::showGraphInterval = true;
        display::showingDialog = true;
        clearPage();
        refreshPage(true, 76);
      }
    }
    if (display::settingsPageZeroScrollPos <= 4) {
      if (display::touch_x >= 680 && display::touch_x <= 750 && display::touch_y >= 370 - scrollMargin && display::touch_y <= 400 - scrollMargin) { // setrtc
        beep();
        rtc.refresh();
        user::rtcDayOfWeek = rtc.dayOfTheWeek();
        user::rtcSecond = rtc.second();
        user::rtcMinute = rtc.minute();
        user::rtcHour = rtc.hour();
        user::rtcDay = rtc.day();
        user::rtcMonth = rtc.month();
        if (rtc.year() >= 24)
          user::rtcYear = rtc.year();
        else
          user::rtcYear = 24;
        display::showRTCtime = true;
        clearPage();
        refreshPage(true, 77);
      }
    }
    if (display::settingsPageZeroScrollPos <= 5) {
      if (display::touch_x >= 680 && display::touch_x <= 750 && display::touch_y >= 420 - scrollMargin && display::touch_y <= 450 - scrollMargin) { // convertToFarenheit
        user::convertToF  = !user::convertToF;
        device::settingsAdjusted = true;
        beep();
      }
    }
    if (display::settingsPageZeroScrollPos >= 1 && display::settingsPageZeroScrollPos <= 6) {
      if (display::touch_x >= 680 && display::touch_x <= 750 && display::touch_y >= 470 - scrollMargin && display::touch_y <= 500 - scrollMargin) { // convertToInches
        user::convertToInches = !user::convertToInches;
        device::settingsAdjusted = true;
        beep();
      }
    }
    if (display::settingsPageZeroScrollPos >= 2 && display::settingsPageZeroScrollPos <= 7) {
      if (display::touch_x >= 680 && display::touch_x <= 750 && display::touch_y >= 520 - scrollMargin && display::touch_y <= 550 - scrollMargin) { // convertToTds
        beep();
        tft.fillRect(11, 11, 76, 74, user::backgroundColor);
        user::convertToTds = !user::convertToTds;
        device::settingsAdjusted = true;
        if (user::convertToTds)
          drawPageIcon(5, 23, 32, ppmIcon, 280, 64, 35);
        else
          drawPageIcon(5, 26, 32, ecIcon, 256, 57, 36);
      }
    }
    if (display::settingsPageZeroScrollPos >= 2 && display::settingsPageZeroScrollPos <= 7) {
      if (display::touch_x >= 680 && display::touch_x <= 750 && display::touch_y >= 570 - scrollMargin && display::touch_y <= 600 - scrollMargin) { // EC conversion mode
        static uint32_t previousTouch = millis();
        if (millis() - previousTouch >= 500UL) {
          beep();
          if (device::conversionType == device::EU) {
            device::conversionType = device::US;
            gravityTds.setTdsFactor(0.5);
          }
          else if (device::conversionType == device::US) {
            device::conversionType = device::AU;
            gravityTds.setTdsFactor(0.7);
          }
          else if (device::conversionType == device::AU) {
            device::conversionType = device::EU;
            gravityTds.setTdsFactor(0.64);
          }
          previousTouch = millis();
        }
      }
    }
  }
}

void settingsOnePageTouched() {
  if (display::showSystemLogs) {
    // vertical menu slider
    if (message::systemLogPos > 6) {
      static uint32_t lastTouchTime = 0;
      if (millis() - lastTouchTime >= 1500UL) {
        if (display::touch_x >= 760 && display::touch_x <= 800 && display::touch_y >= 100 && display::touch_y <= 140) {
          if (display::systemLogScrollPos > 0) {
            display::systemLogScrollPos--;
            refreshPage(true, 78);
            lastTouchTime = millis();
            beep();
            clearPage();
          }
        } 
        else if (display::touch_x >= 760 && display::touch_x <= 800 && display::touch_y > 140 && display::touch_y < 430) {
          display::systemLogScrollPos = map(display::touch_y, 140, 430, 0, message::systemLogPos - 5);
          if (display::systemLogScrollPos > message::systemLogPos - 6)
            display::systemLogScrollPos = message::systemLogPos - 6;
          //Serial.print(F("settingsPageZero slider menu pos = ")); Serial.println(display::systemLogScrollPos);
          refreshPage(true, 79);
          lastTouchTime = millis();
          beep();
          clearPage();
        } 
        else if (display::touch_x >= 760 && display::touch_x <= 800 && display::touch_y >= 430 && display::touch_y <= 470) {
          if (display::systemLogScrollPos < message::systemLogPos - 6) {
            display::systemLogScrollPos++;
            refreshPage(true, 80);
            lastTouchTime = millis();
            beep();
            clearPage();
          }
        }       
      }
    }
    // exit
    if (display::touch_x >= 390 && display::touch_x <= 490 && display::touch_y >= 430 && display::touch_y <= 479) {
      beep();
      display::showSystemLogs = false;
      refreshPage(true, 81);
      clearPage();
    }
    else if (display::touch_x >= 770 && display::touch_x <= 800 && display::touch_y >= 120 && display::touch_y <= 140) { // show info dialog
      message::infoPos = 28;
      display::showingDialog = true;
      display::showInfoDialog = true;
      refreshPage(true, 82);
      display::infoDialogDisplayTime = millis();
    }
  }
  else if (display::showWifiSsid) {
    if (!display::showKeyboard) {
      if (display::touch_x >= 235 && display::touch_x <= 580 && display::touch_y >= 250 && display::touch_y <= 300) {
        loadKeyBoard(0);
        display::showingDialog = true;
      }
      else if (millis() - device::keyBoardClosedTime >= 1500) {
        if (display::touch_x >= 260 && display::touch_x <= 420 && display::touch_y >= 430 && display::touch_y <= 470) { // cancel
          beep();
          display::showWifiSsid = false;
          clearPage();
          display::showingDialog = false;
          refreshPage(true, 83);
        }
        else if (display::touch_x >= 460 && display::touch_x <= 620 && display::touch_y >= 430 && display::touch_y <= 470) { // confirm
          beep();
          wifi::connectionTime = millis() + 5000UL;
          display::showWifiSsid = false;
          clearPage();
          display::showingDialog = false;
          refreshPage(true, 84);
        }
      }
      else if (display::touch_x >= 770 && display::touch_x <= 800 && display::touch_y >= 120 && display::touch_y <= 140) { // show info dialog
        message::infoPos = 33;
        display::showingDialog = true;
        display::showInfoDialog = true;
        refreshPage(true, 85);
        display::infoDialogDisplayTime = millis();
      }
    }
    else {
      static uint32_t previousKeyTouch;
      if (millis() - previousKeyTouch > 500UL) {
        keyboardTouched(wifi::ssid, 16);
        previousKeyTouch = millis();
      }
    }
  }
  else if (display::showWifiPassword) {
    if (!display::showKeyboard) {
      if (display::touch_x >= 235 && display::touch_x <= 580 && display::touch_y >= 250 && display::touch_y <= 300) {
        loadKeyBoard(0);
        display::showingDialog = true;
      }
      else if (millis() - device::keyBoardClosedTime >= 1500) {
        if (display::touch_x >= 260 && display::touch_x <= 420 && display::touch_y >= 430 && display::touch_y <= 470) { // cancel
          beep();
          display::showWifiPassword = false;
          clearPage();
          display::showingDialog = false;
          refreshPage(true, 86);
        }
        else if (display::touch_x >= 460 && display::touch_x <= 620 && display::touch_y >= 430 && display::touch_y <= 470) { // confirm
          beep();
          wifi::connectionTime = millis() + 5000UL;
          display::showWifiPassword = false;
          clearPage();
          display::showingDialog = false;
          refreshPage(true, 87);
        }
        else if (display::touch_x >= 770 && display::touch_x <= 800 && display::touch_y >= 120 && display::touch_y <= 140) { // show info dialog
          message::infoPos = 34;
          display::showingDialog = true;
          display::showInfoDialog = true;
          refreshPage(true, 88);
          display::infoDialogDisplayTime = millis();
        }
      }
    }
    else {
      static uint32_t previousKeyTouch;
      if (millis() - previousKeyTouch > 500UL) {
        keyboardTouched(wifi::password, 16);
        previousKeyTouch = millis();
      }
    }
  }
  else if (user::resetSettings) {
    if (display::touch_x >= 284 && display::touch_x <= 422 && display::touch_y >= 368 && display::touch_y <= 414) { // cancel factory reset
      beep();
      user::resetSettings = false;
      refreshPage(true, 89);
      clearPage();
    }
    else if (display::touch_x >= 460 && display::touch_x <= 638 && display::touch_y >= 368 && display::touch_y <= 414) { // continue with factory reset
      beep();
      reset();
      // TO DO
    }
  }
  else {
    // vertical menu slider
    static uint32_t lastTouchTime = 0;
    if (millis() - lastTouchTime >= 1500UL) {
      if (display::touch_x >= 760 && display::touch_x <= 800 && display::touch_y >= 100 && display::touch_y <= 140) {
        if (display::settingsPageOneScrollPos > 0) {
          display::settingsPageOneScrollPos--;
          refreshPage(true, 90);
          beep();
          clearPage();
        }
      } 
      else if (display::touch_x >= 760 && display::touch_x <= 800 && display::touch_y > 140 && display::touch_y < 430) {
        display::settingsPageOneScrollPos = map(display::touch_y, 140, 430, 0, 6);
        if (display::settingsPageOneScrollPos > 5)
          display::settingsPageOneScrollPos = 5;
        //Serial.print(F("settingsPageZero slider menu pos = ")); Serial.println(display::settingsPageOneScrollPos);
        refreshPage(true, 91);
        beep();
        clearPage();
      } 
      else if (display::touch_x >= 760 && display::touch_x <= 800 && display::touch_y >= 430 && display::touch_y <= 470) {
        if (display::settingsPageOneScrollPos < 5) {
          display::settingsPageOneScrollPos++;
          refreshPage(true, 92);
          beep();
          clearPage();
        }
      }
      lastTouchTime = millis();
    }
    int16_t scrollMargin = display::settingsPageOneScrollPos * 50;  // spacing is 50px
    if (display::settingsPageOneScrollPos == 0) {
      if (display::touch_x >= 680 && display::touch_x <= 750 && display::touch_y >= 170 - scrollMargin && display::touch_y <= 200 - scrollMargin) { // Show system logs
        beep();
        display::showSystemLogs = true;
        refreshPage(true, 93);
        clearPage();
      }
    }
    if (display::settingsPageOneScrollPos <= 1) {
      if (display::touch_x >= 680 && display::touch_x <= 750 && display::touch_y >= 220 - scrollMargin && display::touch_y <= 250 - scrollMargin) { // enable Wifi
        static uint32_t previousWifiOnOffTime = millis();
        if (millis() >= previousWifiOnOffTime + 1000UL) {
          beep();
          wifi::wifiEnabled = !wifi::wifiEnabled;
          digitalWrite(pin::espTransistor, wifi::wifiEnabled);
          wifi::connectionTime = millis();
          Serial.print(F("Wifi AP ")); Serial.println(wifi::wifiEnabled  ? F("enabled") : F("disabled"));    
          previousWifiOnOffTime = millis();
        }
      }
    }
    if (display::settingsPageOneScrollPos <= 2) {
     if (display::touch_x >= 680 && display::touch_x <= 750 && display::touch_y >= 270 - scrollMargin && display::touch_y <= 300 - scrollMargin) { // Set WiFi SSID
        beep();
        display::showWifiSsid = true;
        refreshPage(true, 94);
        clearPage();
      }
    }
    if (display::settingsPageOneScrollPos <= 3) {
     if (display::touch_x >= 680 && display::touch_x <= 750 && display::touch_y >= 320 - scrollMargin && display::touch_y <= 350 - scrollMargin) { // Set WiFi password
        beep();
        display::showWifiPassword = true;
        refreshPage(true, 95);
        clearPage();
      }
    }
    if (display::settingsPageOneScrollPos <= 4) {
      if (display::touch_x >= 680 && display::touch_x <= 750 && display::touch_y >= 370 - scrollMargin && display::touch_y <= 400 - scrollMargin) { // enable WiFi hidden network
        wifi::hiddenNetwork = !wifi::hiddenNetwork;
        beep();
        wifi::connectionTime = millis() + 5000UL;
      }
    }
    if (display::settingsPageOneScrollPos <= 5) {
      if (display::touch_x >= 680 && display::touch_x <= 750 && display::touch_y >= 420 - scrollMargin && display::touch_y <= 450 - scrollMargin) { // disableLED
        beep();
        user::disableLED = !user::disableLED;
        user::disableLED ? sendToSlave('L', 1) : sendToSlave('L', 0);
      }
    }
    if (display::settingsPageOneScrollPos >= 1 && display::settingsPageOneScrollPos <= 6) {
      if (display::touch_x >= 680 && display::touch_x <= 750 && display::touch_y >= 470 - scrollMargin && display::touch_y <= 500 - scrollMargin) { // disableBeeper
        user::disableBeeper = !user::disableBeeper;
        beep();
      }
    }
    if (display::settingsPageOneScrollPos >= 2 && display::settingsPageOneScrollPos <= 7) {
      if (display::touch_x >= 680 && display::touch_x <= 750 && display::touch_y >= 520 - scrollMargin && display::touch_y <= 550 - scrollMargin) { // clear graph history
        sensor::sensorArrayPos = 0;
        beep();
      }
    }
    if (display::settingsPageOneScrollPos >= 3 && display::settingsPageOneScrollPos <= 8) {
      if (display::touch_x >= 680 && display::touch_x <= 750 && display::touch_y >= 570 - scrollMargin && display::touch_y <= 600 - scrollMargin) { // clear max mins
        beep();
        clearMaxMins();
        setMaxMins();
      }
    }
    if (display::settingsPageOneScrollPos >= 4 && display::settingsPageOneScrollPos <= 9) {
      if (display::touch_x >= 680 && display::touch_x <= 750 && display::touch_y >= 620 - scrollMargin && display::touch_y <= 650 - scrollMargin) { // reset system logs
        beep();
        clearSystemLogs();
      }
    }
    if (display::settingsPageOneScrollPos >= 5 && display::settingsPageOneScrollPos <= 10) {
      if (display::touch_x >= 680 && display::touch_x <= 750 && display::touch_y >= 670 - scrollMargin && display::touch_y <= 720 - scrollMargin) { // reset all device Settings
        user::resetSettings = true;
        refreshPage(true, 96);
        beep();
      }
    }
  }
}

void settingsTwoPageTouched() {
  if (display::showNumberOfDosers) {
    if (display::touch_x >= 370 && display::touch_x <= 420 && display::touch_y >= 350 && display::touch_y <= 400) {// numberOfDosers time down
      user::numberOfDosers = adjustValue(user::numberOfDosers, -1, 4, 6);
      device::settingsAdjusted = true;
    }
    else if (display::touch_x >= 500 && display::touch_x <= 550 && display::touch_y >= 350 && display::touch_y <= 400) {// numberOfDosers time up
      user::numberOfDosers = adjustValue(user::numberOfDosers, 1, 4, 6);
      device::settingsAdjusted = true;
    }
    else if (display::touch_x >= 390 && display::touch_x <= 490 && display::touch_y >= 430 && display::touch_y <= 479) {// exit
      beep();
      clearPage();
      display::showNumberOfDosers = false;
      refreshPage(true, 97);    
      display::showingDialog = false;
    }
    else if (display::touch_x >= 770 && display::touch_x <= 800 && display::touch_y >= 120 && display::touch_y <= 140) { // show info dialog
      message::infoPos = 27;
      display::showingDialog = true;
      display::showInfoDialog = true;
      refreshPage(true, 98);
      display::infoDialogDisplayTime = millis();
    }
  }
  else if (display::showDosingInterval) {
    if (display::touch_x >= 370 && display::touch_x <= 420 && display::touch_y >= 350 && display::touch_y <= 400) {// dosingInterval time down
      user::dosingInterval = adjustValue(user::dosingInterval, -1, 1, 240);
      device::settingsAdjusted = true;
    }
    else if (display::touch_x >= 500 && display::touch_x <= 550 && display::touch_y >= 350 && display::touch_y <= 400) {// dosingInterval time up
      user::dosingInterval = adjustValue(user::dosingInterval, 1, 1, 240);
      device::settingsAdjusted = true;
    }
    else if (display::touch_x >= 390 && display::touch_x <= 490 && display::touch_y >= 430 && display::touch_y <= 479) {// exit
      beep();
      clearPage();
      display::showDosingInterval = false;
      refreshPage(true, 99);    
      display::showingDialog = false;
    }
    else if (display::touch_x >= 770 && display::touch_x <= 800 && display::touch_y >= 120 && display::touch_y <= 140) { // show info dialog
      message::infoPos = 26;
      display::showingDialog = true;
      display::showInfoDialog = true;
      refreshPage(true, 100);
      display::infoDialogDisplayTime = millis();
    }
  }
  else if (display::showEcDosingMode) {
    if (display::touch_x >= 190 && display::touch_x <= 700 && display::touch_y >= 220 && display::touch_y <= 270) { // EC dosing mode precise
      beep();
      user::ecDosingMode = user::PRECISE;
      device::settingsAdjusted = true;
    }
    else if (display::touch_x >= 190 && display::touch_x <= 700 && display::touch_y >= 320 && display::touch_y <= 370) { // EC dosing mode incremental
      beep();
      user::ecDosingMode = user::INCREMENTAL;
      device::settingsAdjusted = true;
    }
    else if (display::touch_x >= 390 && display::touch_x <= 490 && display::touch_y >= 430 && display::touch_y <= 479) {// exit
      beep();
      clearPage();
      display::showEcDosingMode = false;
      refreshPage(true, 101);    
      display::showingDialog = false;
    }
    else if (display::touch_x >= 770 && display::touch_x <= 800 && display::touch_y >= 120 && display::touch_y <= 140) { // show info dialog
      message::infoPos = 29;
      display::showingDialog = true;
      display::showInfoDialog = true;
      refreshPage(true, 102);
      display::infoDialogDisplayTime = millis();
    }
  }
  else if (display::showPhDosingMode) {
    if (display::touch_x >= 190 && display::touch_x <= 700 && display::touch_y >= 220 && display::touch_y <= 270) { // PH dosing mode precise
      beep();
      user::phDosingMode = user::PRECISE;
      device::settingsAdjusted = true;
    }
    else if (display::touch_x >= 190 && display::touch_x <= 700 && display::touch_y >= 320 && display::touch_y <= 370) { // PH dosing mode incremental
      beep();
      user::phDosingMode = user::INCREMENTAL;
      device::settingsAdjusted = true;
    }
    else if (display::touch_x >= 390 && display::touch_x <= 490 && display::touch_y >= 430 && display::touch_y <= 479) {// exit
      beep();
      clearPage();
      display::showPhDosingMode = false;
      refreshPage(true, 103);    
      display::showingDialog = false;
    }
    else if (display::touch_x >= 770 && display::touch_x <= 800 && display::touch_y >= 120 && display::touch_y <= 140) { // show info dialog
      message::infoPos = 30;
      display::showingDialog = true;
      display::showInfoDialog = true;
      refreshPage(true, 104);
      display::infoDialogDisplayTime = millis();
    }
  }
  else if (display::showEcTdsValue) {
    if (display::touch_x >= 195 && display::touch_x <= 245 && display::touch_y >= 385 && display::touch_y <= 445) {  // ec solution down
      sensor::ecSolution = adjustValue(sensor::ecSolution, -0.1, 1, 10);
      sensor::tdsSolution = convertEcToTds(sensor::ecSolution);
      device::settingsAdjusted = true;
    }
    else if (display::touch_x >= 295 && display::touch_x <= 345 && display::touch_y >= 385 && display::touch_y <= 445) {  // ec solution up
      sensor::ecSolution = adjustValue(sensor::ecSolution, 0.1, 0.1, 10);
      sensor::tdsSolution = convertEcToTds(sensor::ecSolution);
      device::settingsAdjusted = true;
    }
    else if (display::touch_x >= 565 && display::touch_x <= 615 && display::touch_y >= 385 && display::touch_y <= 445) {  // tds solution down
      sensor::tdsSolution = adjustValue(sensor::tdsSolution, -0.1, 1, 9999);
      sensor::ecSolution = convertTdsToEc(sensor::tdsSolution);
      device::settingsAdjusted = true;
    }
    else if (display::touch_x >= 665 && display::touch_x <= 715 && display::touch_y >= 385 && display::touch_y <= 445) {  // tds solution up
      sensor::tdsSolution = adjustValue(sensor::tdsSolution, 0.1, 1, 9999);
      sensor::ecSolution = convertTdsToEc(sensor::tdsSolution);
      device::settingsAdjusted = true;
    }
    else if (display::touch_x >= 390 && display::touch_x <= 490 && display::touch_y >= 430 && display::touch_y <= 479) {// exit
      beep();
      clearPage();
      display::showEcTdsValue = false;
      refreshPage(true, 105);    
      display::showingDialog = false;
    }
    else if (display::touch_x >= 770 && display::touch_x <= 800 && display::touch_y >= 120 && display::touch_y <= 140) { // show info dialog
      message::infoPos = 31;
      display::showingDialog = true;
      display::showInfoDialog = true;
      refreshPage(true, 106);
      display::infoDialogDisplayTime = millis();
    }
  }
  else if (display::showPhDownUpValue) {
    if (display::touch_x >= 195 && display::touch_x <= 245 && display::touch_y >= 385 && display::touch_y <= 445) {  // ph down solution down
      sensor::phDownSolution = adjustValue(sensor::phDownSolution, -0.1, 1, 14);
      device::settingsAdjusted = true;
    }
    else if (display::touch_x >= 295 && display::touch_x <= 345 && display::touch_y >= 385 && display::touch_y <= 445) {  // ph down solution up
      sensor::phDownSolution = adjustValue(sensor::phDownSolution, 0.1, 1, 14);
      device::settingsAdjusted = true;
    }
    else if (display::touch_x >= 565 && display::touch_x <= 615 && display::touch_y >= 385 && display::touch_y <= 445) {  // ph up solution down
      sensor::phUpSolution = adjustValue(sensor::phUpSolution, -0.1, 1, 14);
      device::settingsAdjusted = true;
    }
    else if (display::touch_x >= 665 && display::touch_x <= 715 && display::touch_y >= 385 && display::touch_y <= 445) {  // ph up solution up
      sensor::phUpSolution = adjustValue(sensor::phUpSolution, 0.1, 1, 14);
      device::settingsAdjusted = true;
    }
    else if (display::touch_x >= 390 && display::touch_x <= 490 && display::touch_y >= 430 && display::touch_y <= 479) {// exit
      beep();
      clearPage();
      display::showPhDownUpValue = false;
      refreshPage(true, 107);    
      display::showingDialog = false;
    }
    else if (display::touch_x >= 770 && display::touch_x <= 800 && display::touch_y >= 120 && display::touch_y <= 140) { // show info dialog
      message::infoPos = 32;
      display::showingDialog = true;
      display::showInfoDialog = true;
      refreshPage(true, 108);
      display::infoDialogDisplayTime = millis();
    }
  }
  else {
    // vertical menu slider
    static uint32_t lastTouchTime = 0;
    if (millis() - lastTouchTime >= 1500UL) {
      if (display::touch_x >= 760 && display::touch_x <= 800 && display::touch_y >= 100 && display::touch_y <= 140) {
        if (display::settingsPageTwoScrollPos > 0) {
          display::settingsPageTwoScrollPos--;
          refreshPage(true, 109);
          beep();
          clearPage();
        }
      } 
      else if (display::touch_x >= 760 && display::touch_x <= 800 && display::touch_y > 140 && display::touch_y < 430) {
        display::settingsPageTwoScrollPos = map(display::touch_y, 140, 430, 0, 2);
        if (display::settingsPageTwoScrollPos > 1)
          display::settingsPageTwoScrollPos = 1;
        //Serial.print(F("settingsPageZero slider menu pos = ")); Serial.println(display::settingsPageTwoScrollPos);
        refreshPage(true, 110);
        beep();
        clearPage();
      } 
      else if (display::touch_x >= 760 && display::touch_x <= 800 && display::touch_y >= 430 && display::touch_y <= 470) {
        if (display::settingsPageTwoScrollPos < 1) {
          display::settingsPageTwoScrollPos++;
          refreshPage(true, 112);
          beep();
          clearPage();
        }
      }
      lastTouchTime = millis();
    }
    int16_t scrollMargin = display::settingsPageTwoScrollPos * 50;  // spacing is 50px
    if (display::settingsPageTwoScrollPos <= 0) {
      if (display::touch_x >= 680 && display::touch_x <= 750 && display::touch_y >= 170 - scrollMargin && display::touch_y <= 200 - scrollMargin) { // NumberOfDosers
        beep();
        display::showNumberOfDosers = true;
        display::showingDialog = true;
        clearPage();
        refreshPage(true, 113);
      }
    }
    if (display::settingsPageTwoScrollPos <= 1) {
      if (display::touch_x >= 680 && display::touch_x <= 750 && display::touch_y >= 220 - scrollMargin && display::touch_y <= 250 - scrollMargin) { // DosingInterval
        beep();
        display::showDosingInterval = true;
        display::showingDialog = true;
        clearPage();
        refreshPage(true, 114);
      }
    }
    if (display::settingsPageTwoScrollPos <= 2) {
      if (display::touch_x >= 680 && display::touch_x <= 750 && display::touch_y >= 270 - scrollMargin && display::touch_y <= 300 - scrollMargin) { // ecDosingMode
        beep();
        display::showEcDosingMode = true;
        display::showingDialog = true;
        clearPage();
        refreshPage(true, 115);
      }
    }
    if (display::settingsPageTwoScrollPos <= 3) {
      if (display::touch_x >= 680 && display::touch_x <= 750 && display::touch_y >= 320 - scrollMargin && display::touch_y <= 350 - scrollMargin) { // phDosingMode
        beep();
        display::showPhDosingMode = true;
        display::showingDialog = true;
        clearPage();
        refreshPage(true, 116);
      }
    }
    if (display::settingsPageTwoScrollPos <= 4) {
      if (display::touch_x >= 680 && display::touch_x <= 750 && display::touch_y >= 370 - scrollMargin && display::touch_y <= 400 - scrollMargin) { // Set EC/TDS value
        beep();
        display::showEcTdsValue = true;
        display::showingDialog = true;
        clearPage();
        refreshPage(true, 117);
      }
    }
    if (display::settingsPageTwoScrollPos <= 5) {
      if (display::touch_x >= 680 && display::touch_x <= 750 && display::touch_y >= 420 - scrollMargin && display::touch_y <= 450 - scrollMargin) { // Set PH down/up value
        beep();
        display::showPhDownUpValue = true;
        display::showingDialog = true;
        clearPage();
        refreshPage(true, 118);
      }
    }
    if (display::settingsPageTwoScrollPos >= 1 && display::settingsPageTwoScrollPos <= 6) {
      if (display::touch_x >= 680 && display::touch_x <= 750 && display::touch_y >= 470 - scrollMargin && display::touch_y <= 500 - scrollMargin) { // useEtapeSensor
        static uint32_t previousDMLTime = millis();
        if (millis() >= previousDMLTime + 500UL) {
          if (user::heightSensor == user::SR04)
            user::heightSensor = user::ETAPE;
          else if (user::heightSensor == user::ETAPE)
            user::heightSensor = (device::disableVL53L0X ? user::SR04 : user::VL53L0X);
          else if (user::heightSensor == user::VL53L0X)
            user::heightSensor = user::SR04;
          beep();
          previousDMLTime = millis();
        }
      }
    }
  }
}

void settingsThreePageTouched() {
  // vertical menu slider
  static uint32_t lastTouchTime = 0;
  if (millis() - lastTouchTime >= 1500UL) {
    if (display::touch_x >= 760 && display::touch_x <= 800 && display::touch_y >= 100 && display::touch_y <= 140) {
      if (display::settingsPageThreeScrollPos > 0) {
        display::settingsPageThreeScrollPos--;
        refreshPage(true, 119);
        beep();
        clearPage();
      }
    } 
    else if (display::touch_x >= 760 && display::touch_x <= 800 && display::touch_y > 140 && display::touch_y < 430) {
      display::settingsPageThreeScrollPos = map(display::touch_y, 140, 430, 0, 3);
      if (display::settingsPageThreeScrollPos > 2)
        display::settingsPageThreeScrollPos = 2;
      //Serial.print(F("settingsPageZero slider menu pos = ")); Serial.println(display::settingsPageThreeScrollPos);
      refreshPage(true, 120);
      beep();
      clearPage();
    } 
    else if (display::touch_x >= 760 && display::touch_x <= 800 && display::touch_y >= 430 && display::touch_y <= 470) {
      if (display::settingsPageThreeScrollPos < 2) {
        display::settingsPageThreeScrollPos++;
        refreshPage(true, 121);
        beep();
        clearPage();
      }
    }
    lastTouchTime = millis();
  }
  int16_t scrollMargin = display::settingsPageThreeScrollPos * 50;
  if (display::settingsPageThreeScrollPos == 0) {
    if (display::touch_x >= 680 && display::touch_x <= 750 && display::touch_y >= 170 - scrollMargin && display::touch_y <= 200 - scrollMargin) { // disable PPM warnings
      user::disablePpmWarnings = !user::disablePpmWarnings;
      device::settingsAdjusted = true;
      beep();
    }
  }
  if (display::settingsPageThreeScrollPos <= 1) {
    if (display::touch_x >= 680 && display::touch_x <= 750 && display::touch_y >= 220 - scrollMargin && display::touch_y <= 250 - scrollMargin) { // disable EC warnings
      user::disableEcWarnings = !user::disableEcWarnings;
      device::settingsAdjusted = true;
      beep();
    }
  }
  if (display::settingsPageThreeScrollPos <= 2) {
    if (display::touch_x >= 680 && display::touch_x <= 750 && display::touch_y >= 270 - scrollMargin && display::touch_y <= 300 - scrollMargin) { // disable PH warnings
      user::disablePhWarnings = !user::disablePhWarnings;
      device::settingsAdjusted = true;
      beep();
    }
  }
  if (display::settingsPageThreeScrollPos <= 3) {
    if (display::touch_x >= 680 && display::touch_x <= 750 && display::touch_y >= 320 - scrollMargin && display::touch_y <= 350 - scrollMargin) { // disable Co2 warnings
      user::disableCo2Warnings = !user::disableCo2Warnings;
      device::settingsAdjusted = true;
      beep();
    }
  }
  if (display::settingsPageThreeScrollPos <= 4) {
    if (display::touch_x >= 680 && display::touch_x <= 750 && display::touch_y >= 370 - scrollMargin && display::touch_y <= 400 - scrollMargin) { // disable water temp warnings
      user::disableWaterTempWarnings = !user::disableWaterTempWarnings;
      device::settingsAdjusted = true;
      beep();
    }
  }
  if (display::settingsPageThreeScrollPos <= 5) {
    if (display::touch_x >= 680 && display::touch_x <= 750 && display::touch_y >= 420 - scrollMargin && display::touch_y <= 450 - scrollMargin) { // disable height warnings
      user::disableWaterHeightWarnings = !user::disableWaterHeightWarnings;
      device::settingsAdjusted = true;
      beep();
    }
  }
  if (display::settingsPageThreeScrollPos >= 1 && display::settingsPageThreeScrollPos <= 6) {
    if (display::touch_x >= 680 && display::touch_x <= 750 && display::touch_y >= 470 - scrollMargin && display::touch_y <= 500 - scrollMargin) { // disable air temp warnings
      user::disableAirTempWarnings = !user::disableAirTempWarnings;
      device::settingsAdjusted = true;
      beep();
    }
  }
  if (display::settingsPageThreeScrollPos >= 2 && display::settingsPageThreeScrollPos <= 7) {
    if (display::touch_x >= 680 && display::touch_x <= 750 && display::touch_y >= 520 - scrollMargin && display::touch_y <= 550 - scrollMargin) { // disable humidity warnings
      user::disableHumidityWarnings = !user::disableHumidityWarnings;
      device::settingsAdjusted = true;
      beep();
    }
  }
}

void settingsFourPageTouched() {
  static uint32_t etapePageOneContinuePressed = 0;
  if (display::showSr04HeightCalibration) {
    if (display::touch_x >= 284 && display::touch_x <= 422 && display::touch_y >= 368 && display::touch_y <= 414) { // cancel setting the water empty height / volume
      beep();
      display::showSr04HeightCalibration = false;
      display::showingDialog = false;
      refreshPage(true, 122);
      clearPage();
    }
    else if (display::touch_x >= 460 && display::touch_x <= 638 && display::touch_y >= 368 && display::touch_y <= 414) { // continue with setting the water empty height / volume
      beep();
      setTankDepth();
      display::showSr04HeightCalibration = false;
      display::showingDialog = false;
      refreshPage(true, 123);
      clearPage();
    }
  }
  //
  else if (display::showEtapeCalibration == device::PAGE_ONE) {
    if (display::touch_x >= 284 && display::touch_x <= 422 && display::touch_y >= 368 && display::touch_y <= 414) { // cancel Etape Calibration
      beep();
      display::showEtapeCalibration = device::UNCHANGED;
      display::showingDialog = false;
      refreshPage(true, 124);
      clearPage();
    }
    else if (display::touch_x >= 460 && display::touch_x <= 638 && display::touch_y >= 368 && display::touch_y <= 414) { // continue with Etape min reading Calibration
      beep();
      etapePageOneContinuePressed = millis() + 2000UL; // Stop the page 2 continue button being pressed by mistake after the page 1 is pressed
      setEtapeZeroVolumeResistance();
      display::showEtapeCalibration = device::PAGE_TWO;
      refreshPage(true, 125);
    }
  }
  else if (display::showEtapeCalibration == device::PAGE_TWO && millis() >= etapePageOneContinuePressed) {
    if (display::touch_x >= 284 && display::touch_x <= 422 && display::touch_y >= 368 && display::touch_y <= 414) { // cancel Etape Calibration
      beep();
      display::showEtapeCalibration = device::UNCHANGED;
      sensor::temp_etapeZeroVolumeResistance = 0;
      display::showingDialog = false;
      refreshPage(true, 126);
      clearPage();
    }
    else if (display::touch_x >= 460 && display::touch_x <= 638 && display::touch_y >= 368 && display::touch_y <= 414) { // continue with Etape max reading Calibration
      beep();
      setEtapeMaxVolumeResistance();
      display::showEtapeCalibration = device::UNCHANGED;
      display::showingDialog = false;
      refreshPage(true, 127);
      clearPage();
    }
  }
  //
  else if (display::showCo2Calibration) {
    if (display::touch_x >= 284 && display::touch_x <= 422 && display::touch_y >= 368 && display::touch_y <= 414) { // cancel calibrating the Co2 sensor
      beep();
      display::showCo2Calibration = false;
      display::showingDialog = false;
      refreshPage(true, 128);
      clearPage();
    }
    else if (display::touch_x >= 460 && display::touch_x <= 638 && display::touch_y >= 368 && display::touch_y <= 414) { // continue with calibrating the Co2 sensor
      beep();
      refreshPage(true, 129);
      calibrateCo2();
      display::showCo2Calibration = false;
      display::showingDialog = false;
    }
  }
  //
  else if (display::showTdsCalibration) {
    if (millis() - device::lastCalTouch >= 2000UL) {
      if (display::showCalErrorMessage) {
        if (display::touch_x >= 366 && display::touch_x <= 504 && display::touch_y >= 368 && display::touch_y <= 414) { // confirm error message
          display::showCalErrorMessage = false;
          refreshPage(true, 130);
          device::lastCalTouch = millis();
        }
      }
      else {
        if (display::touch_x >= 284 && display::touch_x <= 422 && display::touch_y >= 368 && display::touch_y <= 414) { // cancel Tds Calibration
          beep();
          display::calTdsPageScrollPos = 0;
          display::showTdsCalibration = false;
          display::showingDialog = false;
          refreshPage(true, 131);
          device::lastCalTouch = millis();
          clearPage();
        }
        else if (display::touch_x >= 460 && display::touch_x <= 638 && display::touch_y >= 368 && display::touch_y <= 414) { // continue with Tds Calibration
          clearPage();
          pleaseWaitMessage();       
          if (display::calTdsPageScrollPos == 0) {
            if (tdsCalibration(true)) {
              sensor::tdsKvalueLow = gravityTds.getKvalueLow();         
              if (device::globalDebug) {
                Serial.print(F("tdsKvalueLow: ")); Serial.println(sensor::tdsKvalueLow);
              }
              display::calTdsPageScrollPos++;
            }
            else {       
              display::showCalErrorMessage = true;  // show error message
            }
          }
          else {
            if (tdsCalibration(false)) {
              display::showTdsCalibration = false;
              display::showingDialog = false;         
              sensor::tdsKvalueHigh = gravityTds.getKvalueHigh();
              if (device::globalDebug) {
                Serial.print(F("tdsKvalueHigh: ")); Serial.println(sensor::tdsKvalueLow);
              }
              clearPage();
            }
            else {       
              display::showCalErrorMessage = true;  // show error message
            }
          }
          device::lastCalTouch = millis();
          refreshPage(true, 132);      
        }
      }     
    }
  }
  //
  else if (display::showPhCalibration) {
    if (millis() - device::lastCalTouch >= 2000UL) {
      if (display::showCalErrorMessage) {
        if (display::touch_x >= 366 && display::touch_x <= 504 && display::touch_y >= 368 && display::touch_y <= 414) { // confirm error message
          display::showCalErrorMessage = false;
          display::showingDialog = false;
          refreshPage(true, 133);
          device::lastCalTouch = millis();
        }
      }
      else {
        if (display::touch_x >= 284 && display::touch_x <= 422 && display::touch_y >= 368 && display::touch_y <= 414) { // cancel Ph Calibration
          beep();
          display::calPhPageScrollPos = 0;
          display::showPhCalibration = false;
          display::showingDialog = false;
          refreshPage(true, 134);
          device::lastCalTouch = millis();
          clearPage();
        }
        else if (display::touch_x >= 460 && display::touch_x <= 638 && display::touch_y >= 368 && display::touch_y <= 414) { // continue with Ph Calibration
          beep();
          clearPage();
          pleaseWaitMessage();
          if (phCallbration()) {
            if (display::calPhPageScrollPos < 1) {
              display::calPhPageScrollPos++;
            }
            else {
              display::showPhCalibration = false;
              display::showingDialog = false;
              sensor::phAcidicVoltage = ph.getAcidicVoltage();
              sensor::phNeutralVoltage = ph.getNeutralVoltage();
              clearPage();
            }
          }
          else {       
            display::showCalErrorMessage = true;  // show error message
          }
          device::lastCalTouch = millis();
          refreshPage(true, 135);      
        }
      }
    }
  }
  //
  else if (display::showDoserCalibration) {
    int16_t startPosition = display::calDoserPageScrollPos * 178;
    for (uint8_t n = display::calDoserPageScrollPos; n < display::calDoserPageScrollPos + 4; n++) {
      if (n == 0) {
        if (display::touch_x >= 105 - startPosition && display::touch_x <= 180 - startPosition && display::touch_y >= 370 && display::touch_y <= 410) // doser speed 1 down
          user::doserOneSpeed = adjustValue(user::doserOneSpeed, -1, 1, 255);
        else if (display::touch_x >= 190 - startPosition && display::touch_x <= 268 - startPosition && display::touch_y >= 370 && display::touch_y <= 410) // doser speed 1 up
          user::doserOneSpeed = adjustValue(user::doserOneSpeed, 1, 1, 255);
        else if (display::touch_x >= 120 - startPosition && display::touch_x <= 240 - startPosition && display::touch_y >= 310 && display::touch_y <= 350) // doser 1 prime
          if (!bitRead(device::doserIsPriming, n) && millis() - device::primeTouchTime >= 1500UL)
            prime(1, pin::doserOne, user::doserOneSpeed);
          else if (millis() - device::primeTouchTime >= 1500UL)
            prime(1, pin::doserOne, 0);
      }
      else if (n == 1) {
        if (display::touch_x >= 278 - startPosition && display::touch_x <= 358 - startPosition && display::touch_y >= 370 && display::touch_y <= 410) // doser speed 2 down
          user::doserTwoSpeed = adjustValue(user::doserTwoSpeed, -1, 1, 255);
        else if (display::touch_x >= 368 - startPosition && display::touch_x <= 448 - startPosition && display::touch_y >= 370 && display::touch_y <= 410) // doser speed 2 up
          user::doserTwoSpeed = adjustValue(user::doserTwoSpeed, 1, 1, 255);
        else if (display::touch_x >= 293 - startPosition && display::touch_x <= 413 - startPosition && display::touch_y >= 310 && display::touch_y <= 350) // doser 2 prime
          if (!bitRead(device::doserIsPriming, n) && millis() - device::primeTouchTime >= 1500UL)
            prime(2, pin::doserTwo, user::doserTwoSpeed);
          else if (millis() - device::primeTouchTime >= 1500UL)
            prime(2, pin::doserTwo, 0);
      }
      else if (n == 2) {
        if (display::touch_x >= 458 - startPosition && display::touch_x <= 538 - startPosition && display::touch_y >= 370 && display::touch_y <= 410) // doser speed 3 down
          user::doserThreeSpeed = adjustValue(user::doserThreeSpeed, -1, 1, 255);
        else if (display::touch_x >= 548 - startPosition && display::touch_x <= 625 - startPosition && display::touch_y >= 370 && display::touch_y <= 410) // doser speed 3 up
          user::doserThreeSpeed = adjustValue(user::doserThreeSpeed, 1, 1, 255);
        else if (display::touch_x >= 473 - startPosition && display::touch_x <= 593 - startPosition && display::touch_y >= 310 && display::touch_y <= 350) // doser 3 prime
          if (!bitRead(device::doserIsPriming, n) && millis() - device::primeTouchTime >= 1500UL)
            prime(3, pin::doserThree, user::doserThreeSpeed);
          else if (millis() - device::primeTouchTime >= 1500UL)
            prime(3, pin::doserThree, 0);
      }
      else if (n == 3) {
        if (display::touch_x >= 635 - startPosition && display::touch_x <= 702 - startPosition && display::touch_y >= 370 && display::touch_y <= 410) // doser speed 4 down
          user::doserFourSpeed = adjustValue(user::doserFourSpeed, -1, 1, 255);
        else if (display::touch_x >= 712 - startPosition && display::touch_x <= 800 - startPosition && display::touch_y >= 370 && display::touch_y <= 410) // doser speed 4 up
          user::doserFourSpeed = adjustValue(user::doserFourSpeed, 1, 1, 255);
        else if (display::touch_x >= 650 - startPosition && display::touch_x <= 770 - startPosition && display::touch_y >= 310 && display::touch_y <= 350) // doser 4 prime
          if (!bitRead(device::doserIsPriming, n) && millis() - device::primeTouchTime >= 1500UL)
            prime(4, pin::doserFour, user::doserFourSpeed);
          else if (millis() - device::primeTouchTime >= 1500UL)
            prime(4, pin::doserFour, 0);
      }
      else if (n == 4) {
        if (display::touch_x >= 813 - startPosition && display::touch_x <= 880 - startPosition && display::touch_y >= 370 && display::touch_y <= 410) // doser speed 5 down
          user::doserFiveSpeed = adjustValue(user::doserFiveSpeed, -1, 1, 255);
        else if (display::touch_x >= 890 - startPosition && display::touch_x <= 978 - startPosition && display::touch_y >= 370 && display::touch_y <= 410) // doser speed 5 up
          user::doserFiveSpeed = adjustValue(user::doserFiveSpeed, 1, 1, 255);
        else if (display::touch_x >= 828 - startPosition && display::touch_x <= 948 - startPosition && display::touch_y >= 310 && display::touch_y <= 350) // doser 5 prime
          if (!bitRead(device::doserIsPriming, n) && millis() - device::primeTouchTime >= 1500UL)
            prime(5, pin::doserFive, user::doserFiveSpeed);
          else if (millis() - device::primeTouchTime >= 1500UL)
            prime(5, pin::doserFive, 0);
      }
      else if (n == 5) {
        if (display::touch_x >= 991 - startPosition && display::touch_x <= 1058 - startPosition && display::touch_y >= 370 && display::touch_y <= 410) // doser speed 6 down
          user::doserSixSpeed = adjustValue(user::doserSixSpeed, -1, 1, 255);
        else if (display::touch_x >= 1068 - startPosition && display::touch_x <= 1156 - startPosition && display::touch_y >= 370 && display::touch_y <= 410) // doser speed 6 up
          user::doserSixSpeed = adjustValue(user::doserSixSpeed, 1, 1, 255);
        else if (display::touch_x >= 1006 - startPosition && display::touch_x <= 1126 - startPosition && display::touch_y >= 310 && display::touch_y <= 350) // doser 6 prime
          if (!bitRead(device::doserIsPriming, n) && millis() - device::primeTouchTime >= 1500UL)
            prime(6, pin::doserSix, user::doserSixSpeed);
          else if (millis() - device::primeTouchTime >= 1500UL)
            prime(6, pin::doserSix, 0);
      }
    }
    if (display::touch_x >= 400 && display::touch_x <= 500 && display::touch_y >= 410 && display::touch_y <= 460) { // exit
      beep();
      display::showDoserCalibration = false;
      display::showingDialog = false;
      refreshPage(true, 136);
      clearPage();
      // save profile - speed could vary due to fluids viscosity and volatge so per profile save thus no auto save ?
    }
    else if (display::touch_x >= 770 && display::touch_x <= 800 && display::touch_y >= 120 && display::touch_y <= 140) { // show info dialog
      message::infoPos = 22;
      display::showingDialog = true;
      display::showInfoDialog = true;
      refreshPage(true, 137);
      display::infoDialogDisplayTime = millis();
    }
  }
  //
  else if (display::touch_x >= 700 && display::touch_x <= 770 && display::touch_y >= 170 && display::touch_y <= 200) { // showSr04HeightCalibration
    if (user::heightSensor == user::SR04 || user::heightSensor == user::VL53L0X) {
      beep();
      display::showSr04HeightCalibration = true;
      display::showingDialog = true;
      refreshPage(true, 138);
    }
    else {
      beep();
      display::showEtapeCalibration = device::PAGE_ONE;
      display::showingDialog = true;
      refreshPage(true, 139);
      clearPage();
    }
  }
  else if (display::touch_x >= 700 && display::touch_x <= 770 && display::touch_y >= 220 && display::touch_y <= 250) { // set tds sensor calibration
    beep();
    display::showTdsCalibration = true;
    gravityTds.setRawEcLowSolution(sensor::tdsCalSolutionPart1);
    gravityTds.setRawEcHighSolution(sensor::tdsCalSolutionPart2);
    display::showingDialog = true;
    refreshPage(true, 140);
  }
  else if (display::touch_x >= 700 && display::touch_x <= 770 && display::touch_y >= 270 && display::touch_y <= 300) { // set co2 sensor calibration
    beep();
    display::showCo2Calibration = true;
    display::showingDialog = true;
    refreshPage(true, 141);
  }
  else if (display::touch_x >= 700 && display::touch_x <= 770 && display::touch_y >= 320 && display::touch_y <= 350) { // set ph sensor calibration
    beep();
    device::phCalStage = 0;
    display::showPhCalibration = true;
    display::showingDialog = true;
    refreshPage(true, 142);
    clearPage();
  }
  else if (display::touch_x >= 700 && display::touch_x <= 770 && display::touch_y >= 370 && display::touch_y <= 400) { // showDoserCalibration
    beep();
    display::showDoserCalibration = true;
    display::showingDialog = true;
    refreshPage(true, 143);
    clearPage();
  }
  else if (display::touch_x >= 700 && display::touch_x <= 770 && display::touch_y >= 420 && display::touch_y <= 470) { // showTouchCalibration
    beep();
    display::showTouchCalibration = 1;
    //display::showingDialog = true;
    refreshPage(true, 144);
    clearPage();
  }
}

void ecTdsPageTouched() {
  if (user::convertToTds) {
    if (display::touch_x >= 195 && display::touch_x <= 245 && display::touch_y >= 385 && display::touch_y <= 445) {  // min target ppm down
      user::targetMinTds = adjustValue(user::targetMinTds, -1, 1, user::targetMaxTds - 1);
      device::settingsAdjusted = true;
    }
    else if (display::touch_x >= 295 && display::touch_x <= 345 && display::touch_y >= 385 && display::touch_y <= 445) {  // min target ppm up
      user::targetMinTds = adjustValue(user::targetMinTds, 1, 1, user::targetMaxTds - 1);
      device::settingsAdjusted = true;
    }
    else if (display::touch_x >= 565 && display::touch_x <= 615 && display::touch_y >= 385 && display::touch_y <= 445) {  // max target ppm down
      user::targetMaxTds = adjustValue(user::targetMaxTds, -1, user::targetMinTds + 1, 999);
      device::settingsAdjusted = true;
    }
    else if (display::touch_x >= 665 && display::touch_x <= 715 && display::touch_y >= 385 && display::touch_y <= 445) {  // max target ppm up
      user::targetMaxTds = adjustValue(user::targetMaxTds, 1, user::targetMinTds + 1, 999);
      device::settingsAdjusted = true;
    }
    else if (display::touch_x >= 770 && display::touch_x <= 800 && display::touch_y >= 120 && display::touch_y <= 140) { // show info dialog
      message::infoPos = 0;
      display::showingDialog = true;
      display::showInfoDialog = true;
      refreshPage(true, 145);
      display::infoDialogDisplayTime = millis();
    }
  }
  else {
    if (display::touch_x >= 195 && display::touch_x <= 245 && display::touch_y >= 385 && display::touch_y <= 445) {  // min target ec down
      user::targetMinEc = adjustValue(user::targetMinEc, -0.01, 0.1, user::targetMaxEc - 0.1);
      device::settingsAdjusted = true;
    }
    else if (display::touch_x >= 295 && display::touch_x <= 345 && display::touch_y >= 385 && display::touch_y <= 445) {  // min target ec up
      user::targetMinEc = adjustValue(user::targetMinEc, 0.01, 0.1, user::targetMaxEc - 0.1);
      device::settingsAdjusted = true;
    }
    else if (display::touch_x >= 565 && display::touch_x <= 615 && display::touch_y >= 385 && display::touch_y <= 445) {  // max target ec down
      user::targetMaxEc = adjustValue(user::targetMaxEc, -0.01, user::targetMinEc + 0.1, 99);
      device::settingsAdjusted = true;
    }
    else if (display::touch_x >= 665 && display::touch_x <= 715 && display::touch_y >= 385 && display::touch_y <= 445) {  // max target ec up
      user::targetMaxEc = adjustValue(user::targetMaxEc, 0.01, user::targetMinEc + 0.1, 99);
      device::settingsAdjusted = true;
    }
    else if (display::touch_x >= 770 && display::touch_x <= 800 && display::touch_y >= 120 && display::touch_y <= 140) { // show info dialog
      message::infoPos = 1;
      display::showingDialog = true;
      display::showInfoDialog = true;
      refreshPage(true, 146);
      display::infoDialogDisplayTime = millis();
    }
  }
}

void phPageTouched() {
  if (display::touch_x >= 195 && display::touch_x <= 245 && display::touch_y >= 385 && display::touch_y <= 445) { // min target ph down
    user::targetMinPh = adjustValue(user::targetMinPh, -0.01, 1, user::targetMaxPh - 0.1);
    device::settingsAdjusted = true;
  }
  else if (display::touch_x >= 295 && display::touch_x <= 345 && display::touch_y >= 385 && display::touch_y <= 445) { // min target ph up
    user::targetMinPh = adjustValue(user::targetMinPh, 0.01, 1,  user::targetMaxPh - 0.1);
    device::settingsAdjusted = true;
  }
  else if (display::touch_x >= 565 && display::touch_x <= 615 && display::touch_y >= 385 && display::touch_y <= 445) { // max target ph down
    user::targetMaxPh = adjustValue(user::targetMaxPh, -0.01, user::targetMinPh + 0.1, 14);
    device::settingsAdjusted = true;
  }
  else if (display::touch_x >= 665 && display::touch_x <= 715 && display::touch_y >= 385 && display::touch_y <= 445) { // max target ph up
    user::targetMaxPh = adjustValue(user::targetMaxPh, 0.01, user::targetMinPh + 0.1, 14);
    device::settingsAdjusted = true;
  }
  else if (display::touch_x >= 770 && display::touch_x <= 800 && display::touch_y >= 120 && display::touch_y <= 140) { // show info dialog
    message::infoPos = 2;
    display::showingDialog = true;
    display::showInfoDialog = true;
    refreshPage(true, 147);
    display::infoDialogDisplayTime = millis();
  }
}

void co2PageTouched() {
  if (display::co2PageScrollPos == 0) {
    if (display::touch_x >= 195 && display::touch_x <= 245 && display::touch_y >= 385 && display::touch_y <= 445) { // targetCo2 down
      user::targetCo2 = adjustValue(user::targetCo2, -1, 400, 5000);
      device::settingsAdjusted = true;
    }
    else if (display::touch_x >= 295 && display::touch_x <= 345 && display::touch_y >= 385 && display::touch_y <= 445) { // targetCo2 up
      user::targetCo2 = adjustValue(user::targetCo2, 1, 400, 5000);
      device::settingsAdjusted = true;
    }
    else if (display::touch_x >= 565 && display::touch_x <= 615 && display::touch_y >= 385 && display::touch_y <= 445) { // co2 tolerance down
      user::co2Offset = adjustValue(user::co2Offset, -1, 0, 100);
      device::settingsAdjusted = true;
    }
    else if (display::touch_x >= 665 && display::touch_x <= 715 && display::touch_y >= 385 && display::touch_y <= 445) { // co2 tolerance up
      user::co2Offset = adjustValue(user::co2Offset, 1, 0, 100);
      device::settingsAdjusted = true;
    }
    else if (display::touch_x >= 770 && display::touch_x <= 800 && display::touch_y >= 120 && display::touch_y <= 140) { // show info dialog
      message::infoPos = 3;
      display::showingDialog = true;
      display::showInfoDialog = true;
      refreshPage(true, 148);
      display::infoDialogDisplayTime = millis();
    }
  }
  else if (display::co2PageScrollPos == 1) {
    if (display::touch_x >= 145 && display::touch_x <= 210 && display::touch_y >= 340 && display::touch_y <= 420) { // roomLength down
      if (user::convertToInches)
        user::roomLengthInches = adjustValue(user::roomLengthInches, -1, 1, 9999);
      else
        user::roomLengthCm = adjustValue(user::roomLengthCm, -1, 1, 9999);
      device::settingsAdjusted = true;
    }
    else if (display::touch_x >= 225 && display::touch_x <= 290 && display::touch_y >= 340 && display::touch_y <= 420) { // roomLength up
      if (user::convertToInches)
        user::roomLengthInches = adjustValue(user::roomLengthInches, 1, 1, 9999);
      else
        user::roomLengthCm = adjustValue(user::roomLengthCm, 1, 1, 9999);
      device::settingsAdjusted = true;
    }
    else if (display::touch_x >= 350 && display::touch_x <= 415 && display::touch_y >= 340 && display::touch_y <= 420) { // roomWidth down
      if (user::convertToInches)
        user::roomWidthInches = adjustValue(user::roomWidthInches, -1, 1, 9999);
      else
        user::roomWidthCm = adjustValue(user::roomWidthCm, -1, 1, 9999);
      device::settingsAdjusted = true;
    }
    else if (display::touch_x >= 430 && display::touch_x <= 495 && display::touch_y >= 340 && display::touch_y <= 420) { // roomWidth up
      if (user::convertToInches)
        user::roomWidthInches = adjustValue(user::roomWidthInches, 1, 1, 9999);
      else
        user::roomWidthCm = adjustValue(user::roomWidthCm, 1, 1, 9999);
      device::settingsAdjusted = true;
    }
    else if (display::touch_x >= 560 && display::touch_x <= 625 && display::touch_y >= 340 && display::touch_y <= 420) { // roomHeight down
      if (user::convertToInches)
        user::roomHeightInches = adjustValue(user::roomHeightInches, -1, 1, 9999);
      else
        user::roomHeightCm = adjustValue(user::roomHeightCm, -1, 1, 9999);
      device::settingsAdjusted = true;
    }
    else if (display::touch_x >= 640 && display::touch_x <= 705 && display::touch_y >= 340 && display::touch_y <= 420) { // roomHeight up
      if (user::convertToInches)
        user::roomHeightInches = adjustValue(user::roomHeightInches, 1, 1, 9999);
      else
        user::roomHeightCm = adjustValue(user::roomHeightCm, 1, 1, 9999);
      device::settingsAdjusted = true;
    }
    else if (display::touch_x >= 770 && display::touch_x <= 800 && display::touch_y >= 120 && display::touch_y <= 140) { // show info dialog
      message::infoPos = 4;
      display::showingDialog = true;
      display::showInfoDialog = true;
      refreshPage(true, 149);
      display::infoDialogDisplayTime = millis();
    }
  }
  else if (display::co2PageScrollPos == 2) {
    if (display::touch_x >= 145 && display::touch_x <= 210 && display::touch_y >= 340 && display::touch_y <= 420) { // co2Flowrate down
      if (user::convertToInches)
        user::co2FlowrateFeet3 = adjustValue(user::co2FlowrateFeet3, -0.1, 0.1, 99);
      else
        user::co2FlowrateLtrs = adjustValue(user::co2FlowrateLtrs, -0.1, 0.1, 99);
      device::settingsAdjusted = true;
    }
    else if (display::touch_x >= 225 && display::touch_x <= 290 && display::touch_y >= 340 && display::touch_y <= 420) { // co2Flowrate up
      if (user::convertToInches)
        user::co2FlowrateFeet3 = adjustValue(user::co2FlowrateFeet3, 0.1, 0.1, 99);
      else
        user::co2FlowrateLtrs = adjustValue(user::co2FlowrateLtrs, 0.1, 0.1, 99);
      device::settingsAdjusted = true;
    }
    else if (display::touch_x >= 350 && display::touch_x <= 415 && display::touch_y >= 340 && display::touch_y <= 420) { // co2CheckTime down
      if (user::co2CheckTimeMinute >= 15) {
        user::co2CheckTimeMinute -= 15;
      }
      else if (user::co2CheckTimeMinute == 0) {
        user::co2CheckTimeMinute = 45;
        if (user::co2CheckTimeHour > 0)
          user::co2CheckTimeHour--;
        else
          user::co2CheckTimeHour = 23;
      }
      beep();
      device::settingsAdjusted = true;
    }
    else if (display::touch_x >= 430 && display::touch_x <= 495 && display::touch_y >= 340 && display::touch_y <= 420) { // co2CheckTime up
      if (user::co2CheckTimeMinute <= 30) {
        user::co2CheckTimeMinute += 15;
      }
      else {
        user::co2CheckTimeMinute = 0;
        if (user::co2CheckTimeHour < 23)
          user::co2CheckTimeHour++;
        else
          user::co2CheckTimeHour = 0;
      }
      beep();
      device::settingsAdjusted = true;
    }
    else if (display::touch_x >= 560 && display::touch_x <= 625 && display::touch_y >= 340 && display::touch_y <= 720) { // disableFansTimer down
      user::disableFansTimer = adjustValue(user::disableFansTimer, -1, 0, 999);
      device::settingsAdjusted = true;
    }
    else if (display::touch_x >= 640 && display::touch_x <= 705 && display::touch_y >= 340 && display::touch_y <= 720) { // disableFansTimer up
      user::disableFansTimer = adjustValue(user::disableFansTimer, 1, 0, 999);
      device::settingsAdjusted = true;
    }
    else if (display::touch_x >= 770 && display::touch_x <= 800 && display::touch_y >= 120 && display::touch_y <= 140) { // show info dialog
      message::infoPos = 5;
      display::showingDialog = true;
      display::showInfoDialog = true;
      refreshPage(true, 150);
      display::infoDialogDisplayTime = millis();
    }
  }
  else {
    if (display::touch_x >= 140 && display::touch_x <= 290 && display::touch_y >= 310 && display::touch_y <= 350) { // Enable Co2 manual duration
      user::enableManualCo2Duration = !user::enableManualCo2Duration;
      device::settingsAdjusted = true;
      beep();
    }
    else if (display::touch_x >= 390 && display::touch_x <= 430 && display::touch_y >= 400 && display::touch_y <= 470 && user::enableManualCo2Duration) { // Manual Co2 duration time down
      user::manualCo2GasDuration = adjustValue(user::manualCo2GasDuration, -1, 1, 999);
      device::settingsAdjusted = true;
    }
    else if (display::touch_x >= 478 && display::touch_x <= 518 && display::touch_y >= 400 && display::touch_y <= 470 && user::enableManualCo2Duration) { // Manual Co2 duration time up
      user::manualCo2GasDuration = adjustValue(user::manualCo2GasDuration, 1, 1, 999);
      device::settingsAdjusted = true;
    }
    else if (display::touch_x >= 585 && display::touch_x <= 735 && display::touch_y >= 310 && display::touch_y <= 350) { // Disable Co2 control
      user::disableCo2Control = !user::disableCo2Control;
      device::settingsAdjusted = true;
      beep();
    }
    else if (display::touch_x >= 770 && display::touch_x <= 800 && display::touch_y >= 120 && display::touch_y <= 140) { // show info dialog
      message::infoPos = 6;
      display::showingDialog = true;
      display::showInfoDialog = true;
      refreshPage(true, 151);
      display::infoDialogDisplayTime = millis();
    }
  }
}

void waterPageTouched() {
  if (display::waterPageScrollPos == 0) {
    if (display::touch_x >= 195 && display::touch_x <= 245 && display::touch_y >= 385 && display::touch_y <= 445) { // min target water level down
      if (user::convertToInches)
        user::targetMinWaterHeightInches = adjustValue(user::targetMinWaterHeightInches, -1, 1, user::targetMaxWaterHeightInches - 1);
      else
        user::targetMinWaterHeight = adjustValue(user::targetMinWaterHeight, -1, 1, user::targetMaxWaterHeight - 1);
      device::settingsAdjusted = true;
    }
    else if (display::touch_x >= 295 && display::touch_x <= 345 && display::touch_y >= 385 && display::touch_y <= 445) { // min target water level up
      if (user::convertToInches)
        user::targetMinWaterHeightInches = adjustValue(user::targetMinWaterHeightInches, 1, 1, user::targetMaxWaterHeightInches - 1);
      else
        user::targetMinWaterHeight = adjustValue(user::targetMinWaterHeight, 1, 1, user::targetMaxWaterHeight - 1);
      device::settingsAdjusted = true;
    }
    else if (display::touch_x >= 565 && display::touch_x <= 615 && display::touch_y >= 385 && display::touch_y <= 445) { // max target water level down
      if (user::convertToInches)
        user::targetMaxWaterHeightInches = adjustValue(user::targetMaxWaterHeightInches, -1, user::targetMinWaterHeightInches + 1, 99);
      else
        user::targetMaxWaterHeight = adjustValue(user::targetMaxWaterHeight, -1, user::targetMinWaterHeight + 1, 999);
      device::settingsAdjusted = true;
    }
    else if (display::touch_x >= 665 && display::touch_x <= 715 && display::touch_y >= 385 && display::touch_y <= 445) { // max target water level up
      if (user::convertToInches)
        user::targetMaxWaterHeightInches = adjustValue(user::targetMaxWaterHeightInches, 1, user::targetMinWaterHeightInches + 1, 99);
      else
        user::targetMaxWaterHeight = adjustValue(user::targetMaxWaterHeight, 1, user::targetMinWaterHeight + 1, 999);
      device::settingsAdjusted = true;
    }
    else if (display::touch_x >= 770 && display::touch_x <= 800 && display::touch_y >= 120 && display::touch_y <= 140) { // show info dialog
      message::infoPos = 7;
      display::showingDialog = true;
      display::showInfoDialog = true;
      refreshPage(true, 152);
      display::infoDialogDisplayTime = millis();
    }
  }
  else if (display::waterPageScrollPos == 1) {
    if (display::touch_x >= 195 && display::touch_x <= 245 && display::touch_y >= 385 && display::touch_y <= 445) { // min target temperature down
      if (user::convertToF)
        user::targetMinWaterTempF = adjustValue(user::targetMinWaterTempF, -0.1, 1, user::targetMaxWaterTempF - 0.1);
      else
        user::targetMinWaterTemp = adjustValue(user::targetMinWaterTemp, -0.1, 1, user::targetMaxWaterTemp - 0.1);
      device::settingsAdjusted = true;
    }
    else if (display::touch_x >= 295 && display::touch_x <= 345 && display::touch_y >= 385 && display::touch_y <= 445) { // min target temperature up
      if (user::convertToF)
        user::targetMinWaterTempF = adjustValue(user::targetMinWaterTempF, 0.1, 1, user::targetMaxWaterTempF - 0.1);
      else
        user::targetMinWaterTemp = adjustValue(user::targetMinWaterTemp, 0.1, 1, user::targetMaxWaterTemp - 0.1);
      device::settingsAdjusted = true;
    }
    else if (display::touch_x >= 565 && display::touch_x <= 615 && display::touch_y >= 385 && display::touch_y <= 445) { // max target temperature down
      if (user::convertToF)
        user::targetMaxWaterTempF = adjustValue(user::targetMaxWaterTempF, -0.1, user::targetMinWaterTempF + 0.1, 210);
      else
        user::targetMaxWaterTemp = adjustValue(user::targetMaxWaterTemp, -0.1, user::targetMinWaterTemp + 0.1, 99);
      device::settingsAdjusted = true;
    }
    else if (display::touch_x >= 665 && display::touch_x <= 715 && display::touch_y >= 385 && display::touch_y <= 445) { // max target temperature up
      if (user::convertToF)
        user::targetMaxWaterTempF = adjustValue(user::targetMaxWaterTempF, 0.1, user::targetMinWaterTempF + 0.1, 210);
      else
        user::targetMaxWaterTemp = adjustValue(user::targetMaxWaterTemp, 0.1, user::targetMinWaterTemp + 0.1, 99);
      device::settingsAdjusted = true;
    }
    else if (display::touch_x >= 770 && display::touch_x <= 800 && display::touch_y >= 120 && display::touch_y <= 140) { // show info dialog
      message::infoPos = 8;
      display::showingDialog = true;
      display::showInfoDialog = true;
      refreshPage(true, 153);
      display::infoDialogDisplayTime = millis();
    }
  }
  else if (display::waterPageScrollPos == 2) {
    if (display::touch_x >= 230 && display::touch_x <= 280 && display::touch_y >= 400 && display::touch_y <= 450) { // water tank length down
      if (user::convertToInches)
        user::waterTankLengthInches = adjustValue(user::waterTankLengthInches, -1, 1, 999);
      else
        user::waterTankLength = adjustValue(user::waterTankLength, -1, 1, 999);
      device::settingsAdjusted = true;
    }
    else if (display::touch_x >= 295 && display::touch_x <= 345 && display::touch_y >= 385 && display::touch_y <= 445) { // water tank length up
      if (user::convertToInches)
        user::waterTankLengthInches = adjustValue(user::waterTankLengthInches, 1, 1, 999);
      else
        user::waterTankLength = adjustValue(user::waterTankLength, 1, 1, 999);
      device::settingsAdjusted = true;
    }
    else if (display::touch_x >= 585 && display::touch_x <= 635 && display::touch_y >= 400 && display::touch_y <= 450) { // water tank width down
      if (user::convertToInches)
        user::waterTankWidthInches = adjustValue(user::waterTankWidthInches, -1, 1, 999);
      else
        user::waterTankWidth = adjustValue(user::waterTankWidth, -1, 1, 999);
      device::settingsAdjusted = true;
    }
    else if (display::touch_x >= 665 && display::touch_x <= 715 && display::touch_y >= 400 && display::touch_y <= 450) { // water tank width up
      if (user::convertToInches)
        user::waterTankWidthInches = adjustValue(user::waterTankWidthInches, 1, 1, 999);
      else
        user::waterTankWidth = adjustValue(user::waterTankWidth, 1, 1, 999);
      device::settingsAdjusted = true;
    }
    else if (display::touch_x >= 770 && display::touch_x <= 800 && display::touch_y >= 120 && display::touch_y <= 140) { // show info dialog
      message::infoPos = 9;
      display::showingDialog = true;
      display::showInfoDialog = true;
      refreshPage(true, 154);
      display::infoDialogDisplayTime = millis();
    }
  }
  else if (display::waterPageScrollPos == 3) {
    uint16_t calanderX = 110;
    uint16_t calanderY = 205;
    for (uint8_t i = 1; i < 32; i++) {
      if (display::touch_x >= calanderX && display::touch_x <= calanderX + 54 && display::touch_y >= calanderY && display::touch_y <= calanderY + 40) {
        static uint32_t previousCalanderMillis;
        if (millis() - previousCalanderMillis >= 1000UL) {
          bitWrite(user::autoFillDays, i - 1, !(bool)bitRead(user::autoFillDays, i - 1));
          Serial.print(F("calander ")); Serial.print(i - 1); Serial.print(F(" = ")); Serial.println(bitRead(user::autoFillDays, i - 1) ? F("true") : F("false"));
          beep();
          device::settingsAdjusted = true;
          display::refreshCalander = true;
          previousCalanderMillis = millis();
        }
        break;
      }
      calanderX += 54;
      if (i % 7 == 0) {
        calanderX = 110;
        calanderY += 40;
      }
    }
    if (display::touch_x >= 380 && display::touch_x <= 420 && display::touch_y >= 410 && display::touch_y <= 460) { // AutoFill time down
      if (user::autoFillMinute >= 15) {
        user::autoFillMinute -= 15;
      }
      else if (user::autoFillMinute == 0) {
        user::autoFillMinute = 45;
        if (user::autoFillHour > 0)
          user::autoFillHour--;
        else
          user::autoFillHour = 23;
      }
      device::settingsAdjusted = true;
      beep();
    }
    else if (display::touch_x >= 450 && display::touch_x <= 490 && display::touch_y >= 410 && display::touch_y <= 460) { // AutoFill time up
      if (user::autoFillMinute <= 30) {
        user::autoFillMinute += 15;
      }
      else {
        user::autoFillMinute = 0;
        if (user::autoFillHour < 23)
          user::autoFillHour++;
        else
          user::autoFillHour = 0;
      }
      device::settingsAdjusted = true;
      beep();
    }
    else if (display::touch_x >= 565 && display::touch_x <= 720 && display::touch_y >= 320 && display::touch_y <= 364) { // disableDrainAndRefill
      user::disableDrainAndRefill = !user::disableDrainAndRefill;
      device::settingsAdjusted = true;
      beep();
    }
    else if (display::touch_x >= 770 && display::touch_x <= 800 && display::touch_y >= 120 && display::touch_y <= 140) { // show info dialog
      message::infoPos = 10;
      display::showingDialog = true;
      display::showInfoDialog = true;
      refreshPage(true, 155);
      display::infoDialogDisplayTime = millis();
    }
  }
  else if (display::waterPageScrollPos == 4) {
    int16_t startPosition = display::refillDoserPageScrollPos * 178;
    for (uint8_t n = display::refillDoserPageScrollPos; n < display::refillDoserPageScrollPos + 4; n++) {
      if (n == 0) {
        if (display::touch_x >= (105 - startPosition) && display::touch_x <= (180 - startPosition) && display::touch_y >= 420 && display::touch_y <= 480) { // refill doser 1 down
          user::refillDoserOneMills = adjustValue(user::refillDoserOneMills, -1, 0, 999);
          device::settingsAdjusted = true;
        }
        else if (display::touch_x >= (190 - startPosition) && display::touch_x <= (268 - startPosition) && display::touch_y >= 420 && display::touch_y <= 480) { // refill doser 1 up
          user::refillDoserOneMills = adjustValue(user::refillDoserOneMills, 1, 0, 999);
          device::settingsAdjusted = true;
        }
      }
      else if (n == 1) {
        if (display::touch_x >= (278 - startPosition) && display::touch_x <= (358 - startPosition) && display::touch_y >= 420 && display::touch_y <= 480) { // refill doser 2 down
          user::refillDoserTwoMills = adjustValue(user::refillDoserTwoMills, -1, 0, 999);
          device::settingsAdjusted = true;
        }
        else if (display::touch_x >= (368 - startPosition) && display::touch_x <= (448 - startPosition) && display::touch_y >= 420 && display::touch_y <= 480) { // refill doser 2 up
          user::refillDoserTwoMills = adjustValue(user::refillDoserTwoMills, 1, 0, 999);
          device::settingsAdjusted = true;
        }
      }
      else if (n == 2) {
        if (display::touch_x >= (458 - startPosition) && display::touch_x <= (538 - startPosition) && display::touch_y >= 420 && display::touch_y <= 480) { // refill doser 3 down
          user::refillDoserThreeMills = adjustValue(user::refillDoserThreeMills, -1, 0, 999);
          device::settingsAdjusted = true;
        }
        else if (display::touch_x >= (548 - startPosition) && display::touch_x <= (625 - startPosition) && display::touch_y >= 420 && display::touch_y <= 480) { // refill doser 3 up
          user::refillDoserThreeMills = adjustValue(user::refillDoserThreeMills, 1, 0, 999);
          device::settingsAdjusted = true;
        }
      }
      else if (n == 3) {
        if (display::touch_x >= (635 - startPosition) && display::touch_x <= (702 - startPosition) && display::touch_y >= 420 && display::touch_y <= 480) { // refill doser 4 down
          user::refillDoserFourMills = adjustValue(user::refillDoserFourMills, -1, 0, 999);
          device::settingsAdjusted = true;
        }
        else if (display::touch_x >= (712 - startPosition) && display::touch_x <= (800 - startPosition) && display::touch_y >= 420 && display::touch_y <= 480) { // refill doser 4 up
          user::refillDoserFourMills = adjustValue(user::refillDoserFourMills, 1, 0, 999);
          device::settingsAdjusted = true;
        }
      }
      else if (n == 4) {
        if (display::touch_x >= (813 - startPosition) && display::touch_x <= (880 - startPosition) && display::touch_y >= 420 && display::touch_y <= 480) { // refill doser 5 down
          user::refillDoserFiveMills = adjustValue(user::refillDoserFiveMills, -1, 0, 999);
          device::settingsAdjusted = true;
        }
        else if (display::touch_x >= (890 - startPosition) && display::touch_x <= (978 - startPosition) && display::touch_y >= 420 && display::touch_y <= 480) { // refill doser 5 up
          user::refillDoserFiveMills = adjustValue(user::refillDoserFiveMills, 1, 0, 999);
          device::settingsAdjusted = true;
        }
      }
      else if (n == 5) {
        if (display::touch_x >= (991 - startPosition) && display::touch_x <= (1058 - startPosition) && display::touch_y >= 420 && display::touch_y <= 480) { // refill doser 6 down
          user::refillDoserSixMills = adjustValue(user::refillDoserSixMills, -1, 0, 999);
          device::settingsAdjusted = true;
        }
        else if (display::touch_x >= (1068 - startPosition) && display::touch_x <= (1156 - startPosition) && display::touch_y >= 420 && display::touch_y <= 480) { // refill doser 6 up
          user::refillDoserSixMills = adjustValue(user::refillDoserSixMills, 1, 0, 999);
          device::settingsAdjusted = true;
        }
      }
    }
    if (display::touch_x >= 770 && display::touch_x <= 800 && display::touch_y >= 120 && display::touch_y <= 140) { // show info dialog
      message::infoPos = 11;
      display::showingDialog = true;
      display::showInfoDialog = true;
      refreshPage(true, 156);
      display::infoDialogDisplayTime = millis();
    }
  }
}
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
