kawasakizx10rr/HydroController/Code/hydoController_4_9_4/Icons.h

#pragma once

const uint8_t waterTemperatureIcon[418] PROGMEM = { // Height: 62 Width: 54
  0x00, 0x00, 0x03, 0xFF, 0x00, 0x00, 0x00, 0x00, 0x00, 0x1F, 0xFE, 0x00, 0x00, 0x00, 0x00, 0x00,
  0xE0, 0x1C, 0x00, 0x00, 0x3E, 0x00, 0x07, 0x00, 0x38, 0x00, 0x1F, 0xF8, 0x00, 0x18, 0xFC, 0x60,
  0x00, 0x7F, 0xFF, 0xE0, 0x67, 0xF9, 0x80, 0x01, 0xFF, 0xFF, 0x81, 0xD8, 0x66, 0x00, 0x07, 0xFF,
  0xFE, 0x06, 0x61, 0x98, 0x00, 0x1F, 0xF8, 0x00, 0x1D, 0x86, 0x60, 0x00, 0x7F, 0xE0, 0x00, 0x66,
  0x19, 0x80, 0x01, 0xFF, 0x80, 0x01, 0xD8, 0x66, 0x00, 0x07, 0xFF, 0xFE, 0x06, 0x61, 0x98, 0x00,
  0x1F, 0xFF, 0xF8, 0x1D, 0x86, 0x60, 0x00, 0x7F, 0xFF, 0xE0, 0x66, 0x19, 0x80, 0x01, 0xFF, 0x80,
  0x01, 0xD8, 0x66, 0x00, 0x07, 0xFE, 0x00, 0x06, 0x61, 0x98, 0x00, 0x1F, 0xF8, 0x00, 0x1D, 0x86,
  0x60, 0x00, 0x7F, 0xFF, 0xE0, 0x66, 0x19, 0x80, 0x01, 0xFF, 0xFF, 0x81, 0xD8, 0x66, 0x00, 0x07,
  0xFF, 0xFE, 0x06, 0x61, 0x98, 0x00, 0x1F, 0xF8, 0x00, 0x1D, 0x86, 0x60, 0x00, 0x7F, 0xE0, 0x00,
  0x66, 0x19, 0x80, 0x01, 0xFF, 0x80, 0x01, 0xD8, 0x66, 0x00, 0x07, 0xFF, 0xFE, 0x06, 0x61, 0x98,
  0x00, 0x1F, 0xFF, 0xF8, 0x1D, 0x86, 0x60, 0x00, 0x7F, 0xFF, 0xE0, 0x67, 0xF9, 0x80, 0x01, 0xFF,
  0x80, 0x01, 0xDF, 0xE6, 0x00, 0x07, 0xFE, 0x00, 0x06, 0x7F, 0x98, 0x00, 0x0F, 0xF8, 0x00, 0x1D,
  0xFE, 0x60, 0x00, 0x7F, 0xE0, 0xF0, 0x67, 0xF9, 0x83, 0xC1, 0xFF, 0x9F, 0xF9, 0xDF, 0xE6, 0x7F,
  0xE7, 0xFE, 0xFF, 0xFE, 0x7F, 0x9F, 0xFF, 0xDF, 0xFF, 0xFF, 0xFD, 0xFE, 0x7F, 0xFF, 0xFF, 0xFF,
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
  0x80, 0x03, 0xE0, 0x00, 0x07, 0xF0, 0x07, 0xF0, 0x00, 0x03, 0xFE, 0x0F, 0xF8, 0x00, 0x00, 0xFF,
  0xFF, 0xF8, 0x00, 0x00, 0x3F, 0xFF, 0xF8, 0x00, 0x00, 0x07, 0xFF, 0xF0, 0x00, 0x00, 0x00, 0xFF,
  0xE0, 0x00, 0x00, 0x00, 0x0F, 0x80, 0x00, 0x00,
};
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
