kawasakizx10rr/HydroController/Code/ESP8266/esp8266_V1.1/SerialData.ino

void receiveSerialData(const uint8_t a_page, const uint8_t a_slide) {
  bool readData = false;
  uint16_t index = 0, charCnt = 0;
  char buffer[64] {0};
  //uint32_t timeout = millis() + 500UL;
  while (true) { // millis() <= timeout
    if (Serial.available() > 0) {
      char c = Serial.read();
      // reset local variables
      if (c == '!') {
        memset(buffer, 0, 64);
        //Serial.print("?SOT\n"); // Start of transmission
        index = 0;
        charCnt = 0;
        readData = true;
        //timeout = millis();
      }
      else if (c == '#' && readData) {
        //Serial.print("?EOT\n");  // End of transmission
        readData = false;
        break;
      }
      // value to be stored
      else if (c == ',' && readData) {
        updateValue(a_page, a_slide, buffer, index);
        //printf("?P %d, I %d\n", a_page, index); // P = page , I = index
        memset(buffer, 0, 64);    
        index++;
        charCnt = 0;
        //timeout = millis();
      }
      // add serial data to buffer
      else if (c >= 32 && c <= 126 && charCnt < 64 && readData) {
        buffer[charCnt++] = c;
      }
    }
    yield();
  } 
}
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
