kawasakizx10rr/HydroController/(commit log)

2022-04-11 Add files via upload
    I have adjusted the hw-432 footprint as it was to large, and i have adjusted the 10k pot footprint for the ph board so it is the same as the pot removed from the ph board as the was not the same footprint
2022-04-24 Add files via upload
    Corrected the HW-432 footprint and PH trim pot
2022-04-24 Add files via upload
    Created a new print method for the RA8875 library which uses way less memory and up to 50% faster draw speeds, note any old RA8875 font will nto work with the new RA8875 0.9 library, but you can create new fonts with my font generator tool.
2023-12-05 Add files via upload
    Fixed an issue with the Number of dosers not clearing the text properly
    Fixed an issue with the Log messages showing random chars due to using the wrong array index
    Improved the scrolling/swiping so that when adjusting a value / holding a button down the scroll is not activated by mistake (300px of pixel touch increments is now required)
    [BasicFunctions.ino, Display.ino, DisplayFunctions.ino, EEPROM.ino, EnviromentalControl.ino, Graphs.ino, Icons.h, Keyboard.ino]
2023-12-05 Add files via upload
    re-enabled the sensor function which was disabled for menu testing
2023-12-05 Add files via upload
    Improved the water heater logic and adjusted the air heater to use the same logic.
2023-12-05 Add files via upload
    Corrected a typo
    [BasicFunctions.ino]
2023-12-05 Add files via upload
    Simplified the fan control logic
2023-12-06 Add files via upload
    Added a #define to easily choose between a DHT11 or HDC1080 temperature and humidity sensor
2023-12-18 Update BasicFunctions.ino
    Corrected an index error in saveLogMessage
    [BasicFunctions.ino]
2023-12-18 Update Touch.ino
    Added debug print out for systemLogs
2023-12-27 Add files via upload
    Corrected an EEPROM mistake causing log errors when restarted
    [BasicFunctions.ino, Display.ino, DisplayFunctions.ino, EEPROM.ino, EnviromentalControl.ino, Graphs.ino, Icons.h, Keyboard.ino]
2024-02-27 Add files via upload
    Tested the VL53L0X, the Serial.print is still enabled for the water height, in sernsors.ino, so comment it out if you want...
2024-03-02 Add files via upload
    Improved the touch accuracy and added touch calibration, changed the light and aux timers to be either cyclic or 24-hr timers
2024-03-03 Add files via upload
    Corrected a the expected number of variables received for a number of web pages and corrected a bug with the doser page
    [SerialData.ino, webCallBacks.ino]
2024-04-20 Add files via upload
    Disabled the serialDebugger function which was used to set the globalDebug flag via the serial monitor.
    Added a print statement to show which function is setting the displayRefresh flag.
